samuelverburg-sys/PATS-MP16-DIY/hardware/mp16/PARTS.md

# PATS MP-16 DIY kit rev 2: parts

Generated from `mp16/design.py` by `tools/parts_table.py`; do not edit by hand.
Check every **unverified** LCSC number in the JLCPCB BOM preview (description, value, package) before ordering.

| Qty | References | Value | Footprint | LCSC | Part | Source of the LCSC number |
|---|---|---|---|---|---|---|
| 1 | SW1 | SHIFT | MX-Hotswap-1U | C41430893 | Kailh CPG151101S11-16 | rev-1 BOM |
| 17 | D1, D2, D3, D4, D5, D6, D7, D8, D9, D10, D11, D12, D13, D14, D15, D16, D17 | SK6812MINI-E | LED_SK6812MINI-E_3.2x2.8mm_P1.5mm_ReverseMount | C5149201 | SK6812MINI-E | Samuel (PATS BOM exports) |
| 20 | C1, C2, C3, C4, C5, C6, C7, C8, C9, C10, C11, C12, C13, C14, C15, C16, C17, C21, C22, C23 | 100n | C_0603_1608Metric | C14663 |  | PATS checked list |
| 1 | SW2 | P1 | MX-Hotswap-1U | C41430893 | Kailh CPG151101S11-16 | rev-1 BOM |
| 1 | SW3 | P2 | MX-Hotswap-1U | C41430893 | Kailh CPG151101S11-16 | rev-1 BOM |
| 1 | SW4 | P3 | MX-Hotswap-1U | C41430893 | Kailh CPG151101S11-16 | rev-1 BOM |
| 1 | SW5 | P4 | MX-Hotswap-1U | C41430893 | Kailh CPG151101S11-16 | rev-1 BOM |
| 1 | SW6 | P5 | MX-Hotswap-1U | C41430893 | Kailh CPG151101S11-16 | rev-1 BOM |
| 1 | SW7 | P6 | MX-Hotswap-1U | C41430893 | Kailh CPG151101S11-16 | rev-1 BOM |
| 1 | SW8 | P7 | MX-Hotswap-1U | C41430893 | Kailh CPG151101S11-16 | rev-1 BOM |
| 1 | SW9 | P8 | MX-Hotswap-1U | C41430893 | Kailh CPG151101S11-16 | rev-1 BOM |
| 1 | SW10 | P9 | MX-Hotswap-1U | C41430893 | Kailh CPG151101S11-16 | rev-1 BOM |
| 1 | SW11 | P10 | MX-Hotswap-1U | C41430893 | Kailh CPG151101S11-16 | rev-1 BOM |
| 1 | SW12 | P11 | MX-Hotswap-1U | C41430893 | Kailh CPG151101S11-16 | rev-1 BOM |
| 1 | SW13 | P12 | MX-Hotswap-1U | C41430893 | Kailh CPG151101S11-16 | rev-1 BOM |
| 1 | SW14 | P13 | MX-Hotswap-1U | C41430893 | Kailh CPG151101S11-16 | rev-1 BOM |
| 1 | SW15 | P14 | MX-Hotswap-1U | C41430893 | Kailh CPG151101S11-16 | rev-1 BOM |
| 1 | SW16 | P15 | MX-Hotswap-1U | C41430893 | Kailh CPG151101S11-16 | rev-1 BOM |
| 1 | SW17 | P16 | MX-Hotswap-1U | C41430893 | Kailh CPG151101S11-16 | rev-1 BOM |
| 1 | U4 | 74AHCT1G125 | SOT-23-5 | C52140417 | 74AHCT1G125GV | Samuel (PATS BOM exports) |
| 2 | R1, R42 | 33 | R_0402_1005Metric | C25105 |  | **unverified** |
| 12 | C18, C30, C31, C32, C33, C34, C35, C38, C39, C40, C53, C71 | 100n | C_0402_1005Metric | C1525 |  | **unverified** |
| 1 | ENC1 | PEC11R 24 PPR + switch | RotaryEncoder_Bourns_PEC11R-4215F-S0024 | C143790 | Bourns PEC11R-4215F-S0024 | rev-1 BOM |
| 5 | R2, R3, R11, R24, R31 | 10k | R_0402_1005Metric | C25744 |  | **unverified** |
| 2 | C19, C20 | 10n | C_0402_1005Metric | C15195 |  | **unverified** |
| 3 | U1, U2, U3 | 74HC165 | TSSOP-16_4.4x5mm_P0.65mm | C80696 | 74HC165PW | PATS checked list |
| 6 | RN1, RN2, RN3, RN4, RN5, RN6 | 4x10k | R_Array_Convex_4x0603 | C29718 | 4D03WGJ0103T5E | PATS checked list |
| 1 | J2 | OLED SSD1306 I2C | PinSocket_1x04_P2.54mm_Vertical | - |  | none: choose a part |
| 2 | R4, R5 | 4.7k | R_0402_1005Metric | C25900 |  | **unverified** |
| 1 | U10 | RP2040 | QFN-56-1EP_7x7mm_P0.4mm_EP3.2x3.2mm | C2040 | RP2040 | **unverified** |
| 4 | C36, C37, C50, C57 | 1u | C_0402_1005Metric | C52923 |  | **unverified** |
| 1 | U11 | W25Q128JV | SOIC-8_5.23x5.23mm_P1.27mm | C97521 | W25Q128JVSIQ | LCSC listing seen 2026-10-22 |
| 3 | R10, R12, R21 | 1k | R_0402_1005Metric | C11702 |  | **unverified** |
| 1 | SW18 | BOOT | SW_Push_1P1T_NO_CK_KMR2 | C72443 | C&K KMR221GLFS | PATS checked list |
| 1 | SW19 | RESET | SW_Push_1P1T_NO_CK_KMR2 | C72443 | C&K KMR221GLFS | PATS checked list |
| 1 | Y1 | 12MHz | Crystal_SMD_3225-4Pin_3.2x2.5mm | C20625731 | Abracon ABM8-272-T3 | LCSC listing seen 2026-10-22 |
| 2 | C41, C42 | 15p | C_0402_1005Metric | C1548 |  | **unverified** |
| 1 | J3 | USB-C | USB_C_Receptacle_HRO_TYPE-C-31-M-12 | C165948 | HRO TYPE-C-31-M-12 | PATS checked list |
| 2 | R13, R14 | 5.1k | R_0402_1005Metric | C25905 |  | **unverified** |
| 1 | F1 | 1.5A hold | Fuse_1206_3216Metric | - | 1206 PTC, 1.5 A hold, 6 V | none: choose a part |
| 2 | U12, U20 | USBLC6-2SC6 | SOT-23-6 | C2687116 | USBLC6-2SC6 | Samuel (PATS BOM exports) |
| 2 | R15, R16 | 27 | R_0402_1005Metric | C25100 |  | **unverified** |
| 1 | U13 | BQ24074 | VQFN-16-1EP_3x3mm_P0.5mm_EP1.6x1.6mm | C2861252 | BQ24074RGTR | Samuel (PATS BOM exports) |
| 5 | C51, C52, C55, C56, C58 | 10u | C_0603_1608Metric | C85713 | CL10A106MP8NNNC | rev-1 BOM |
| 1 | R20 | 3k | R_0402_1005Metric | - |  | none: choose a part |
| 1 | R22 | 180 | R_0402_1005Metric | - |  | none: choose a part |
| 1 | R23 | 4.12k | R_0603_1608Metric | C2960702 |  | Samuel (PATS BOM exports) |
| 1 | D20 | charge | LED_SideView_XL-1606_RD | C965860 | XINGLIGHT XL-1606SURC | rev-1 BOM |
| 1 | R25 | 1.5k | R_0402_1005Metric | C25867 |  | **unverified** |
| 1 | J7 | LiPo 1S (pin 1 = GND, pin 2 = +) | JST_PH_S2B-PH-K-S_Horizontal | C173752 | JST S2B-PH-K-S(LF)(SN) | rev-1 BOM |
| 1 | Q1 | DMG2305UX | SOT-23 | C150470 | DMG2305UX-7 | LCSC listing seen 2026-10-22 |
| 3 | R26, R27, R29 | 100k | R_0402_1005Metric | C25741 |  | **unverified** |
| 1 | Q2 | MMBT3906 | SOT-23 | C2940 | MMBT3906 | **unverified** |
| 2 | R44, R45 | 1M | R_0402_1005Metric | C26083 |  | **unverified** |
| 1 | SW20 | Power | SW_SPDT_MK-12C02-G015 | C2911519 | G-Switch MK-12C02-G015 | rev-1 BOM |
| 1 | U16 | TPS22917 | SOT-23-6 | C2681320 | TPS22917DBVR | PATS checked list |
| 1 | C54 | 1n | C_0402_1005Metric | C1523 |  | **unverified** |
| 1 | U17 | AP2112K-3.3 | SOT-23-5 | C51118 | AP2112K-3.3TRG1 | PATS checked list |
| 1 | U18 | MT3608 | SOT-23-6 | C84817 | MT3608 | PATS checked list |
| 4 | C24, C60, C61, C62 | 22u | C_0805_2012Metric | C45783 |  | PATS checked list |
| 1 | L1 | 10uH | L_Coilcraft_XAL4040-XXX | C5144883 | XAL4040-103MEC | PATS checked list |
| 1 | D21 | SS34 | D_SMA | C8678 | SS34 | PATS checked list |
| 1 | R30 | 75k | R_0402_1005Metric | - |  | none: choose a part |
| 1 | J4 | MIDI IN | Jack_3.5mm_PJ-320-3P-SMT | C17701688 | PJ-320-3P SMT | rev-1 BOM |
| 1 | C70 | 100p | C_0402_1005Metric | C1546 |  | **unverified** |
| 1 | R40 | 220 | R_0402_1005Metric | C25091 |  | **unverified** |
| 1 | D22 | 1N4148W | D_SOD-123 | C81598 | 1N4148W | **unverified** |
| 1 | U19 | TLP109 | Toshiba_SO6-5P_TLP109 | C406798 | TLP109(TPL,E | rev-1 BOM |
| 1 | R41 | 2.2k | R_0402_1005Metric | C25879 |  | **unverified** |
| 1 | J5 | MIDI OUT | Jack_3.5mm_PJ-320-3P-SMT | C17701688 | PJ-320-3P SMT | rev-1 BOM |
| 1 | R43 | 10 | R_0402_1005Metric | C25077 |  | **unverified** |
| 1 | J6 | I2C (Qwiic) | JST_SH_SM04B-SRSS-TB_1x04-1MP_P1.00mm_Horizontal | C160404 | JST SM04B-SRSS-TB(LF)(SN) | **unverified** |
