samuelverburg-sys/PATS-MP16-DIY/hardware/mp16/fab/mp16-bom.csv

Comment | Designator | Footprint | LCSC Part # | Manufacturer Part
100n | C1,C2,C3,C4,C5,C6,C7,C8,C9,C10,C11,C12,C13,C14,C15,C16,C17,C21,C22,C23 | C_0603_1608Metric | C14663
100n | C18,C30,C31,C32,C33,C34,C35,C38,C39,C40,C53,C71 | C_0402_1005Metric | C1525
10n | C19,C20 | C_0402_1005Metric | C15195
22u | C24,C60,C61,C62 | C_0805_2012Metric | C45783
1u | C36,C37,C50,C57 | C_0402_1005Metric | C52923
15p | C41,C42 | C_0402_1005Metric | C1548
CL10A106MP8NNNC | C51,C52,C55,C56,C58 | C_0603_1608Metric | C85713 | CL10A106MP8NNNC
1n | C54 | C_0402_1005Metric | C1523
100p | C70 | C_0402_1005Metric | C1546
SK6812MINI-E | D1,D2,D3,D4,D5,D6,D7,D8,D9,D10,D11,D12,D13,D14,D15,D16,D17 | LED_SK6812MINI-E_3.2x2.8mm_P1.5mm_ReverseMount | C5149201 | SK6812MINI-E
XINGLIGHT XL-1606SURC | D20 | LED_SideView_XL-1606_RD | C965860 | XINGLIGHT XL-1606SURC
SS34 | D21 | D_SMA | C8678 | SS34
1N4148W | D22 | D_SOD-123 | C81598 | 1N4148W
1.5A hold | F1 | Fuse_1206_3216Metric |  | 1206 PTC, 1.5 A hold, 6 V
HRO TYPE-C-31-M-12 | J3 | USB_C_Receptacle_HRO_TYPE-C-31-M-12 | C165948 | HRO TYPE-C-31-M-12
PJ-320-3P SMT | J4,J5 | Jack_3.5mm_PJ-320-3P-SMT | C17701688 | PJ-320-3P SMT
JST SM04B-SRSS-TB(LF)(SN) | J6 | JST_SH_SM04B-SRSS-TB_1x04-1MP_P1.00mm_Horizontal | C160404 | JST SM04B-SRSS-TB(LF)(SN)
XAL4040-103MEC | L1 | L_Coilcraft_XAL4040-XXX | C5144883 | XAL4040-103MEC
DMG2305UX-7 | Q1 | SOT-23 | C150470 | DMG2305UX-7
MMBT3906 | Q2 | SOT-23 | C2940 | MMBT3906
33 | R1,R42 | R_0402_1005Metric | C25105
10k | R2,R3,R11,R24,R31 | R_0402_1005Metric | C25744
4.7k | R4,R5 | R_0402_1005Metric | C25900
1k | R10,R12,R21 | R_0402_1005Metric | C11702
5.1k | R13,R14 | R_0402_1005Metric | C25905
27 | R15,R16 | R_0402_1005Metric | C25100
3k | R20 | R_0402_1005Metric
180 | R22 | R_0402_1005Metric
4.12k | R23 | R_0603_1608Metric | C2960702
1.5k | R25 | R_0402_1005Metric | C25867
100k | R26,R27,R29 | R_0402_1005Metric | C25741
75k | R30 | R_0402_1005Metric
220 | R40 | R_0402_1005Metric | C25091
2.2k | R41 | R_0402_1005Metric | C25879
10 | R43 | R_0402_1005Metric | C25077
1M | R44,R45 | R_0402_1005Metric | C26083
4D03WGJ0103T5E | RN1,RN2,RN3,RN4,RN5,RN6 | R_Array_Convex_4x0603 | C29718 | 4D03WGJ0103T5E
Kailh CPG151101S11-16 | SW1,SW2,SW3,SW4,SW5,SW6,SW7,SW8,SW9,SW10,SW11,SW12,SW13,SW14,SW15,SW16,SW17 | MX-Hotswap-1U | C41430893 | Kailh CPG151101S11-16
C&K KMR221GLFS | SW18,SW19 | SW_Push_1P1T_NO_CK_KMR2 | C72443 | C&K KMR221GLFS
G-Switch MK-12C02-G015 | SW20 | SW_SPDT_MK-12C02-G015 | C2911519 | G-Switch MK-12C02-G015
74HC165PW | U1,U2,U3 | TSSOP-16_4.4x5mm_P0.65mm | C80696 | 74HC165PW
74AHCT1G125GV | U4 | SOT-23-5 | C52140417 | 74AHCT1G125GV
RP2040 | U10 | QFN-56-1EP_7x7mm_P0.4mm_EP3.2x3.2mm | C2040 | RP2040
W25Q128JVSIQ | U11 | SOIC-8_5.23x5.23mm_P1.27mm | C97521 | W25Q128JVSIQ
USBLC6-2SC6 | U12,U20 | SOT-23-6 | C2687116 | USBLC6-2SC6
BQ24074RGTR | U13 | VQFN-16-1EP_3x3mm_P0.5mm_EP1.6x1.6mm | C2861252 | BQ24074RGTR
TPS22917DBVR | U16 | SOT-23-6 | C2681320 | TPS22917DBVR
AP2112K-3.3TRG1 | U17 | SOT-23-5 | C51118 | AP2112K-3.3TRG1
MT3608 | U18 | SOT-23-6 | C84817 | MT3608
TLP109(TPL,E | U19 | Toshiba_SO6-5P_TLP109 | C406798 | TLP109(TPL,E
Abracon ABM8-272-T3 | Y1 | Crystal_SMD_3225-4Pin_3.2x2.5mm | C20625731 | Abracon ABM8-272-T3
