samuelverburg-sys/PATS-MP16-DIY/enclosure/stl/Midplate.stl

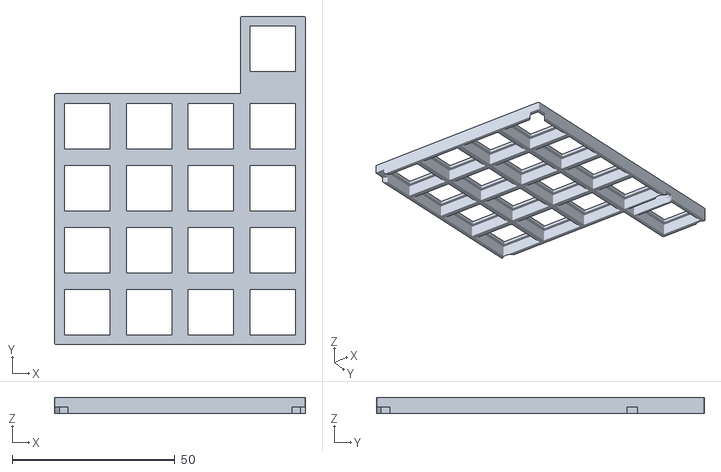
[picture p2: CAD file, 2026-10-22]
enclosure/stl/Midplate.stl
77.2 x 101.0 x 5.00
