samuelverburg-sys/PATS-MP16-DIY/enclosure/stl/Switch.stl

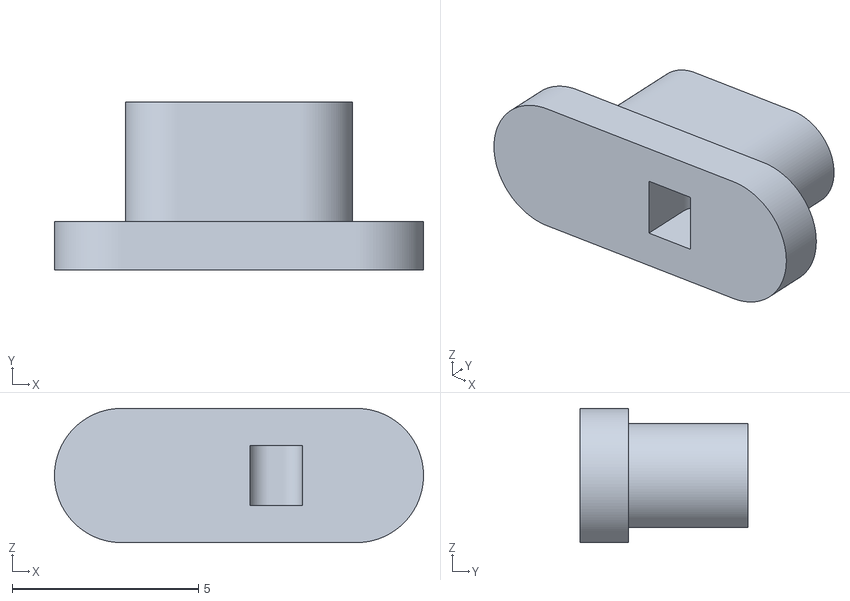
[picture p3: CAD file, 2026-10-22]
enclosure/stl/Switch.stl
9.90 x 4.50 x 3.60
