samuelverburg-sys/PATS-MP16-DIY/enclosure/stl/Top.stl

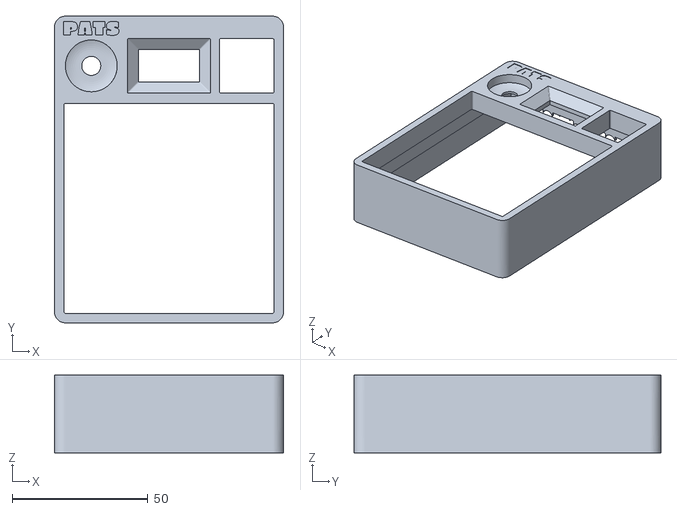
[picture p4: CAD file, 2026-10-22]
enclosure/stl/Top.stl
84.2 x 112.8 x 28.6
