samuelverburg-sys/PATS-MP16-DIY/enclosure/stl/OLED standoff.stl

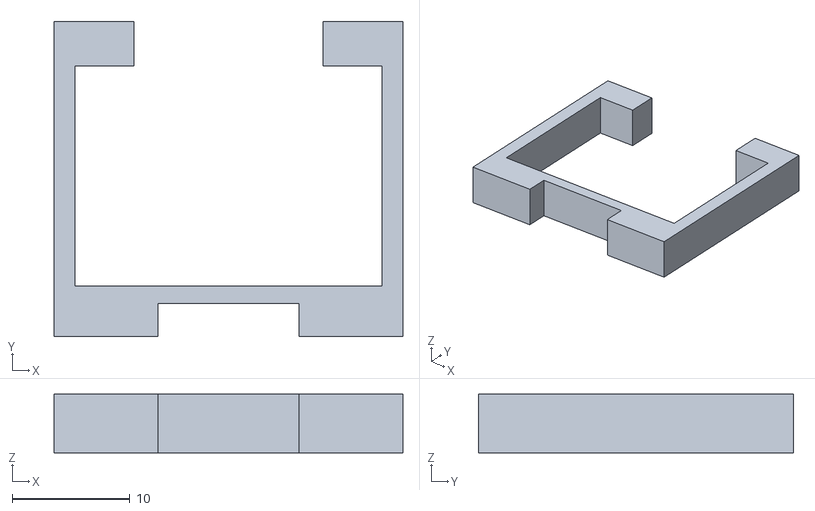
[picture p6: CAD file, 2026-10-22]
enclosure/stl/OLED standoff.stl
29.6 x 26.8 x 5.00
