samuelverburg-sys/PATS-MP16-DIY/enclosure/stl/Bottom.stl

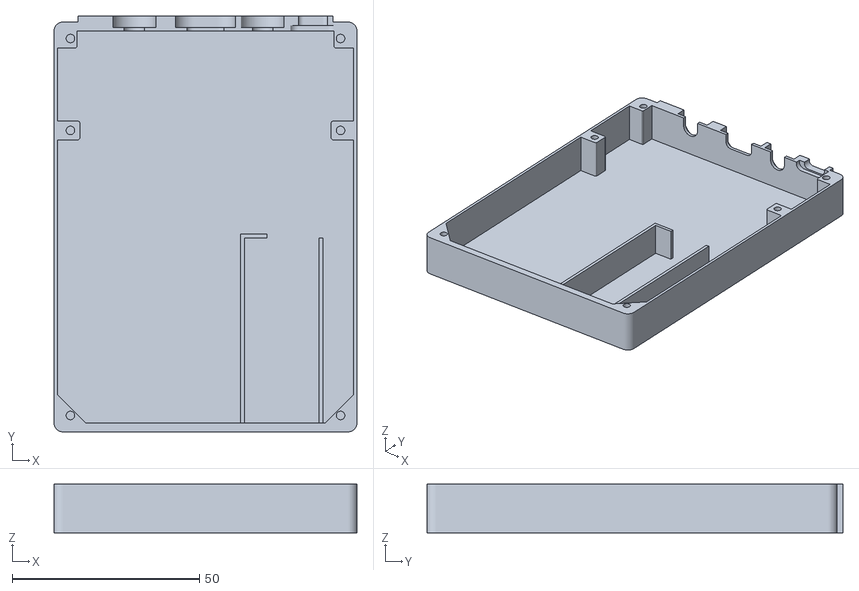
[picture p7: CAD file, 2026-10-22]
enclosure/stl/Bottom.stl
81.0 x 111.2 x 13.0
