samuelverburg-sys/PATS-MP16-DIY/(list of files, drawings)

Other design files:
hardware/reference/rev1-pcb.easyeda.json
hardware/reference/rev1-schematic.easyeda.json
