samuelverburg-sys/PATS-MP16-DIY/hardware/mp16/mp16.kicad_pcb

## KiCad design hardware/mp16/mp16.kicad_pcb (2026-11-05)

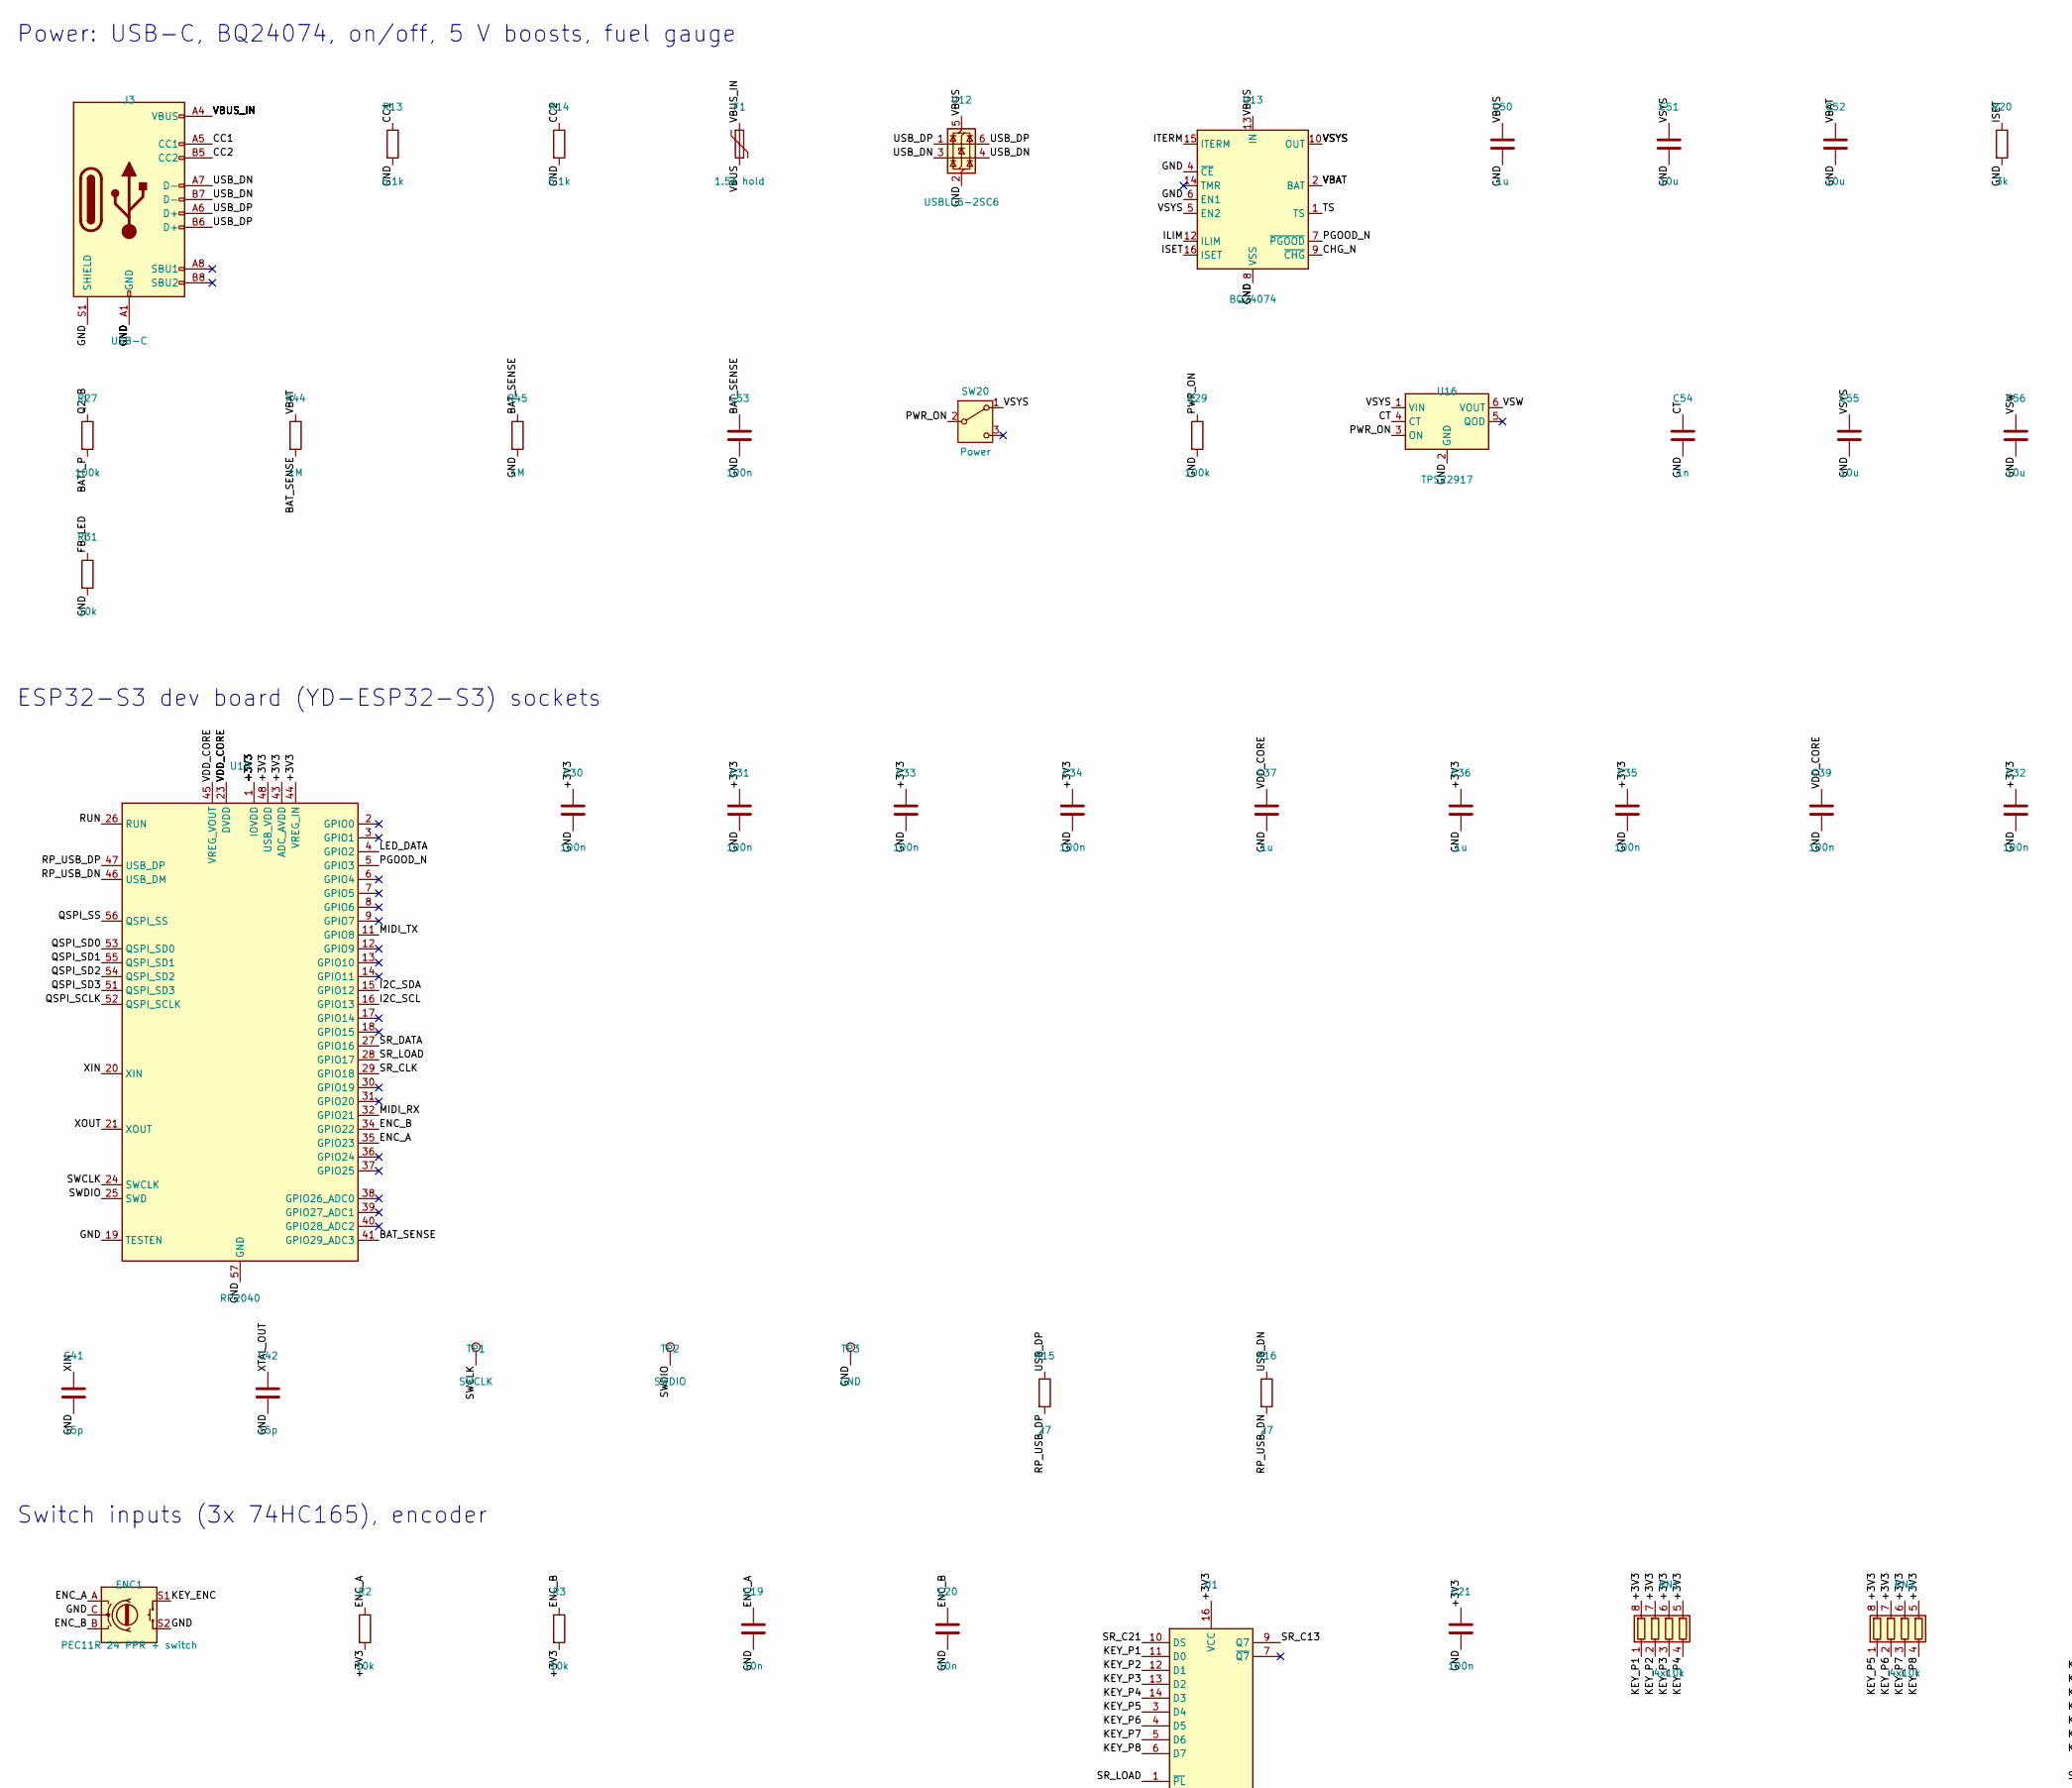
[picture p8: schematic mp16.kicad_sch, PATS MP-16 DIY kit rev 2, part in row 1, column 1]

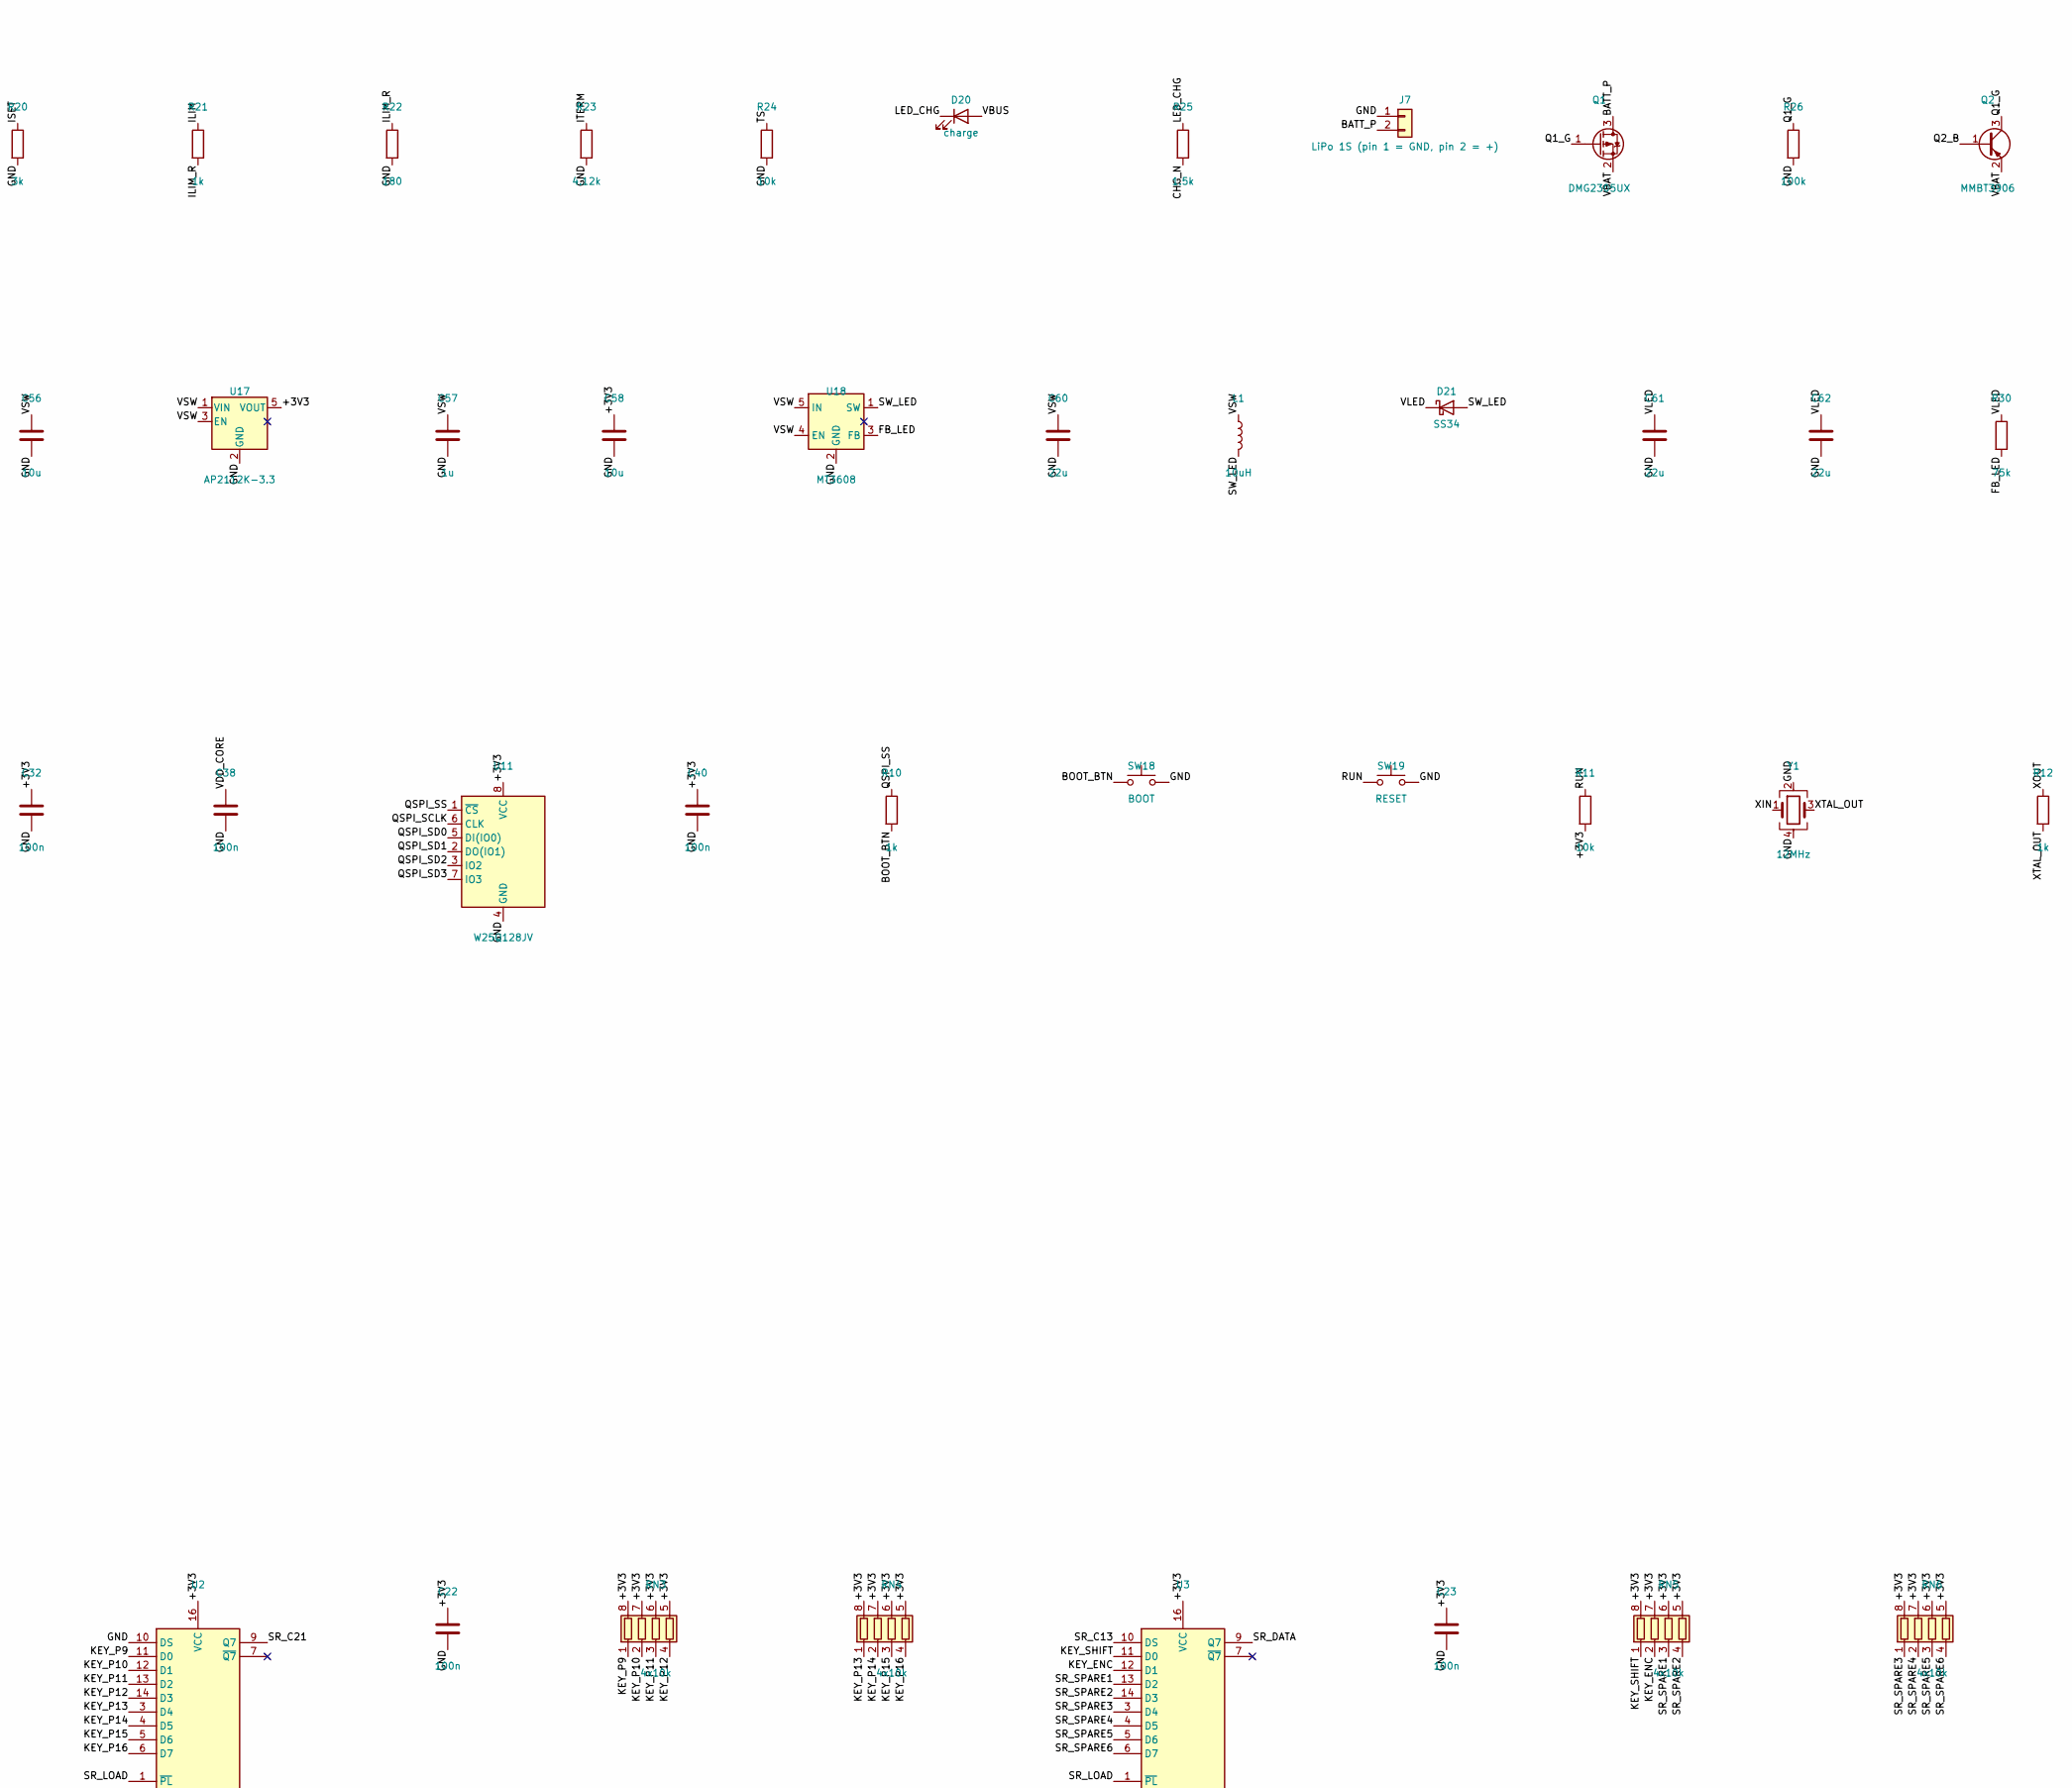
[picture p9: schematic mp16.kicad_sch, PATS MP-16 DIY kit rev 2, part in row 1, column 2]

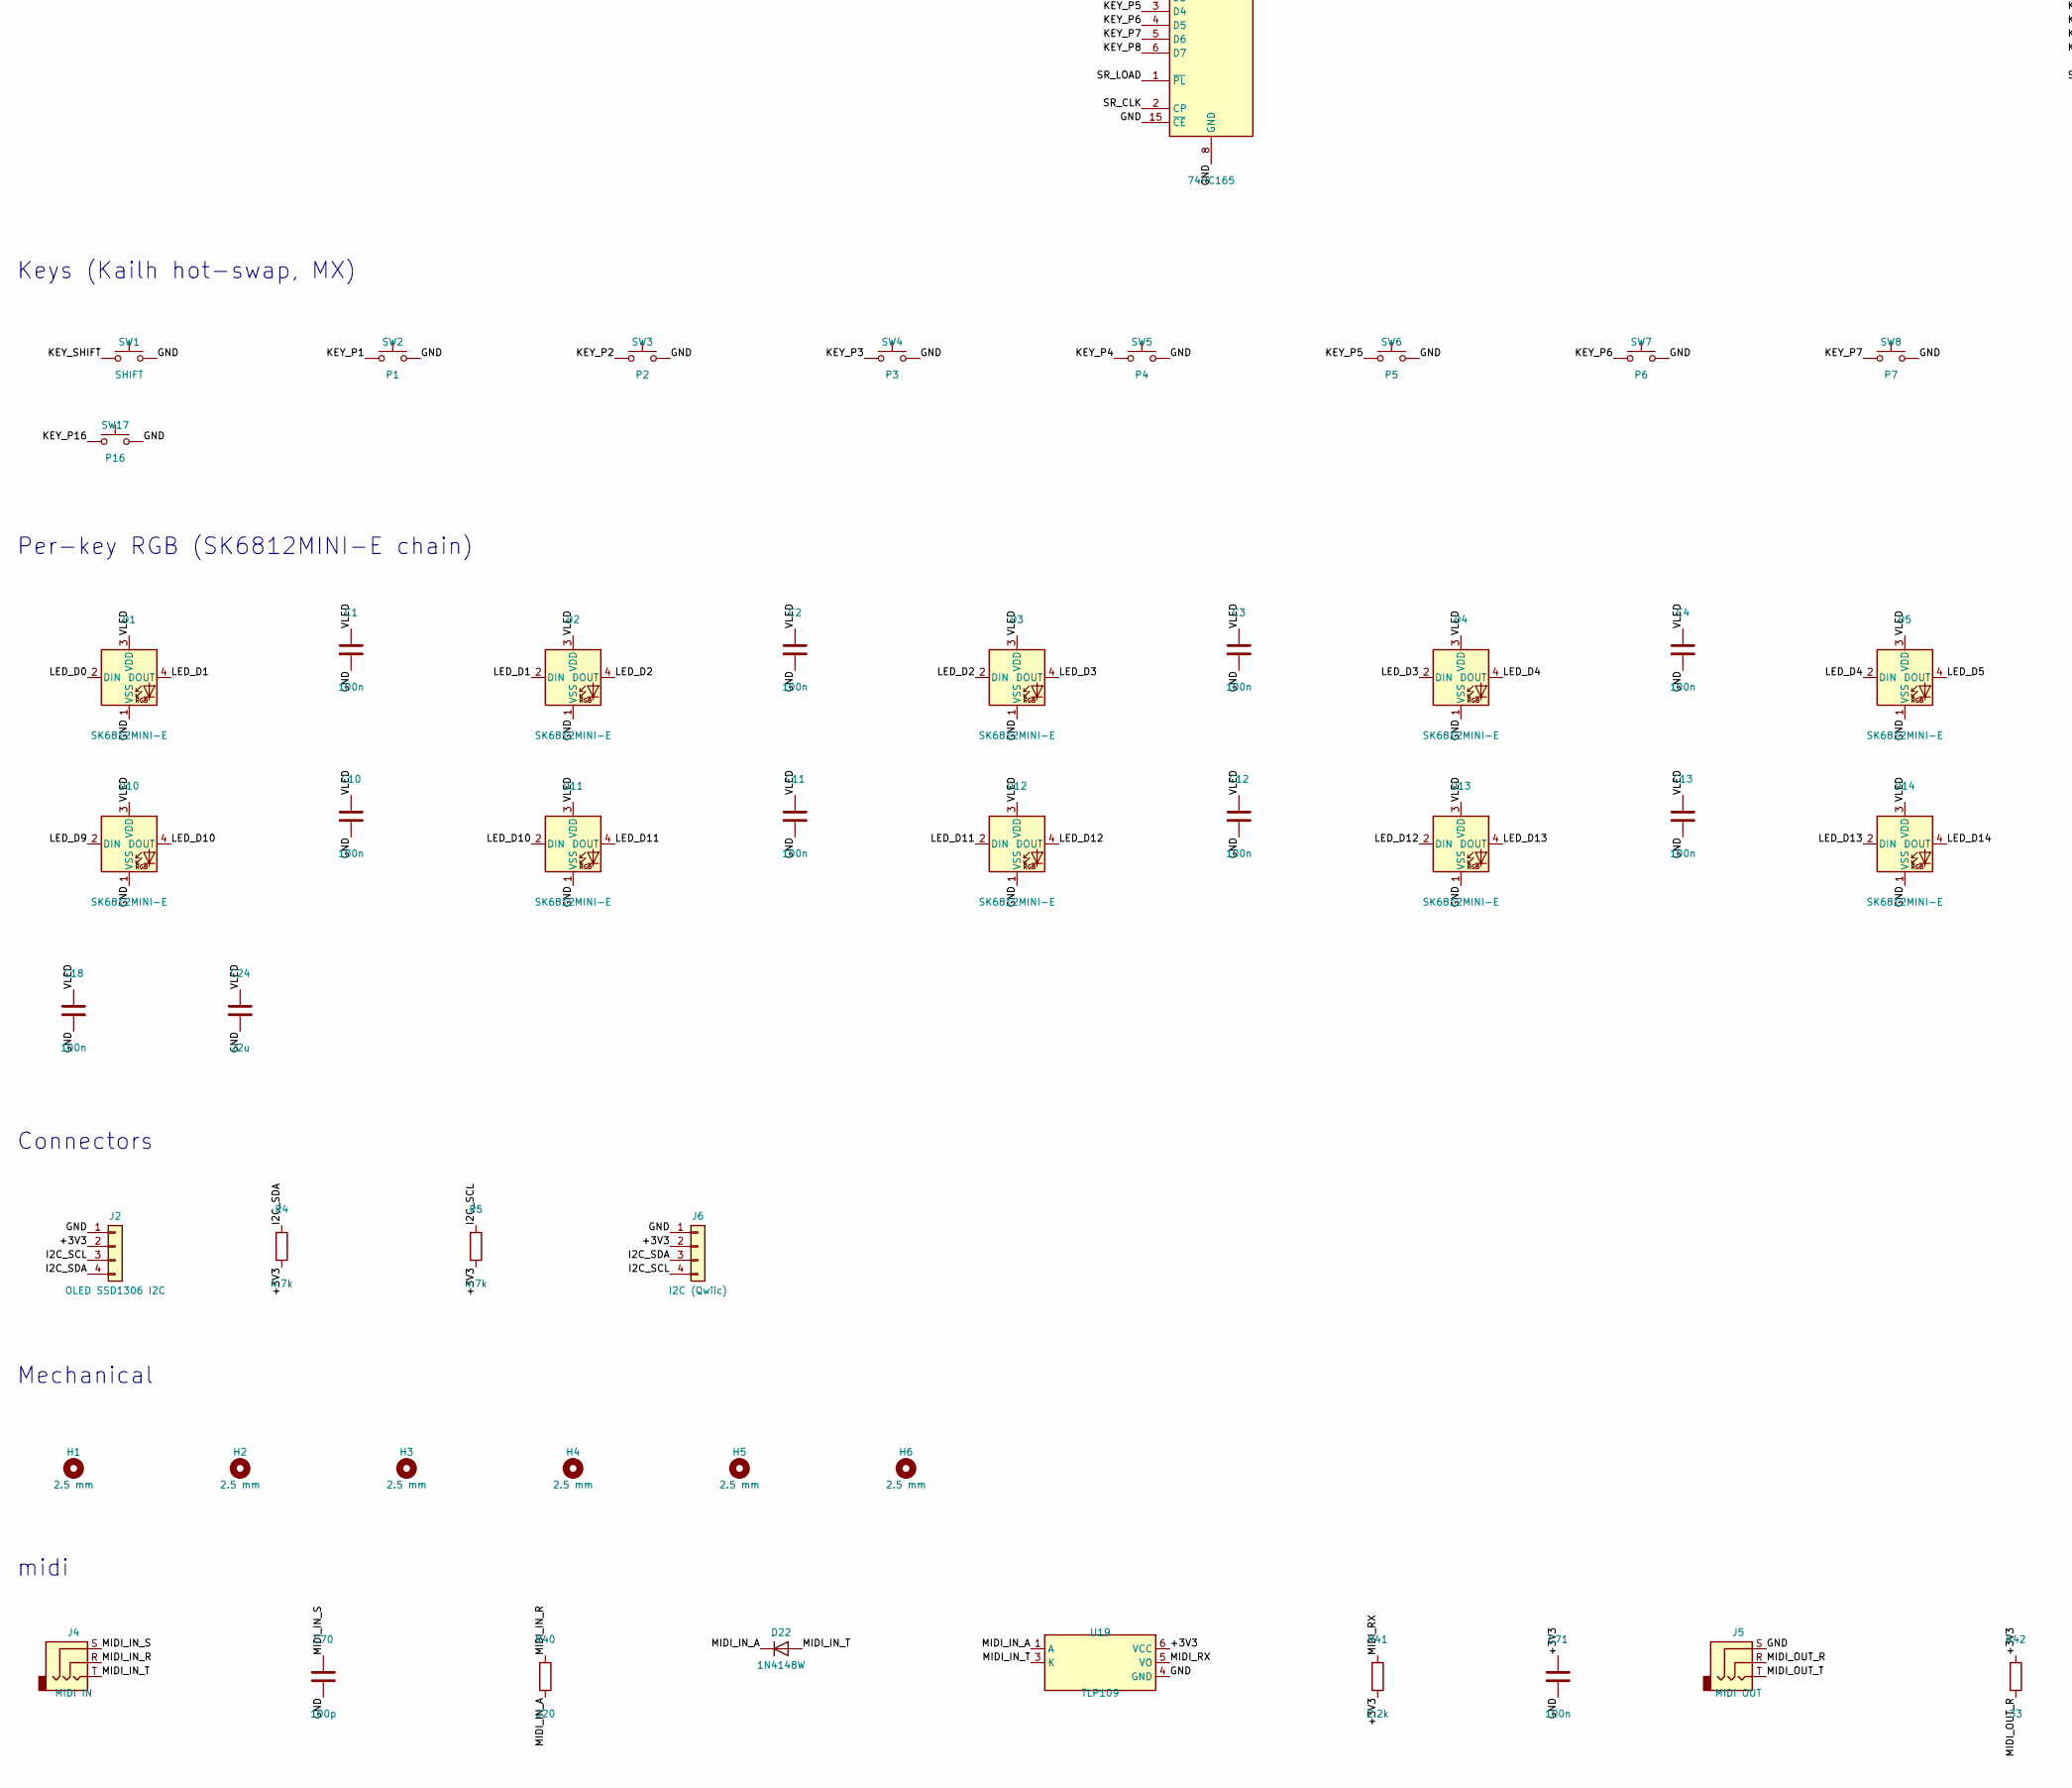
[picture p10: schematic mp16.kicad_sch, PATS MP-16 DIY kit rev 2, part in row 2, column 1]

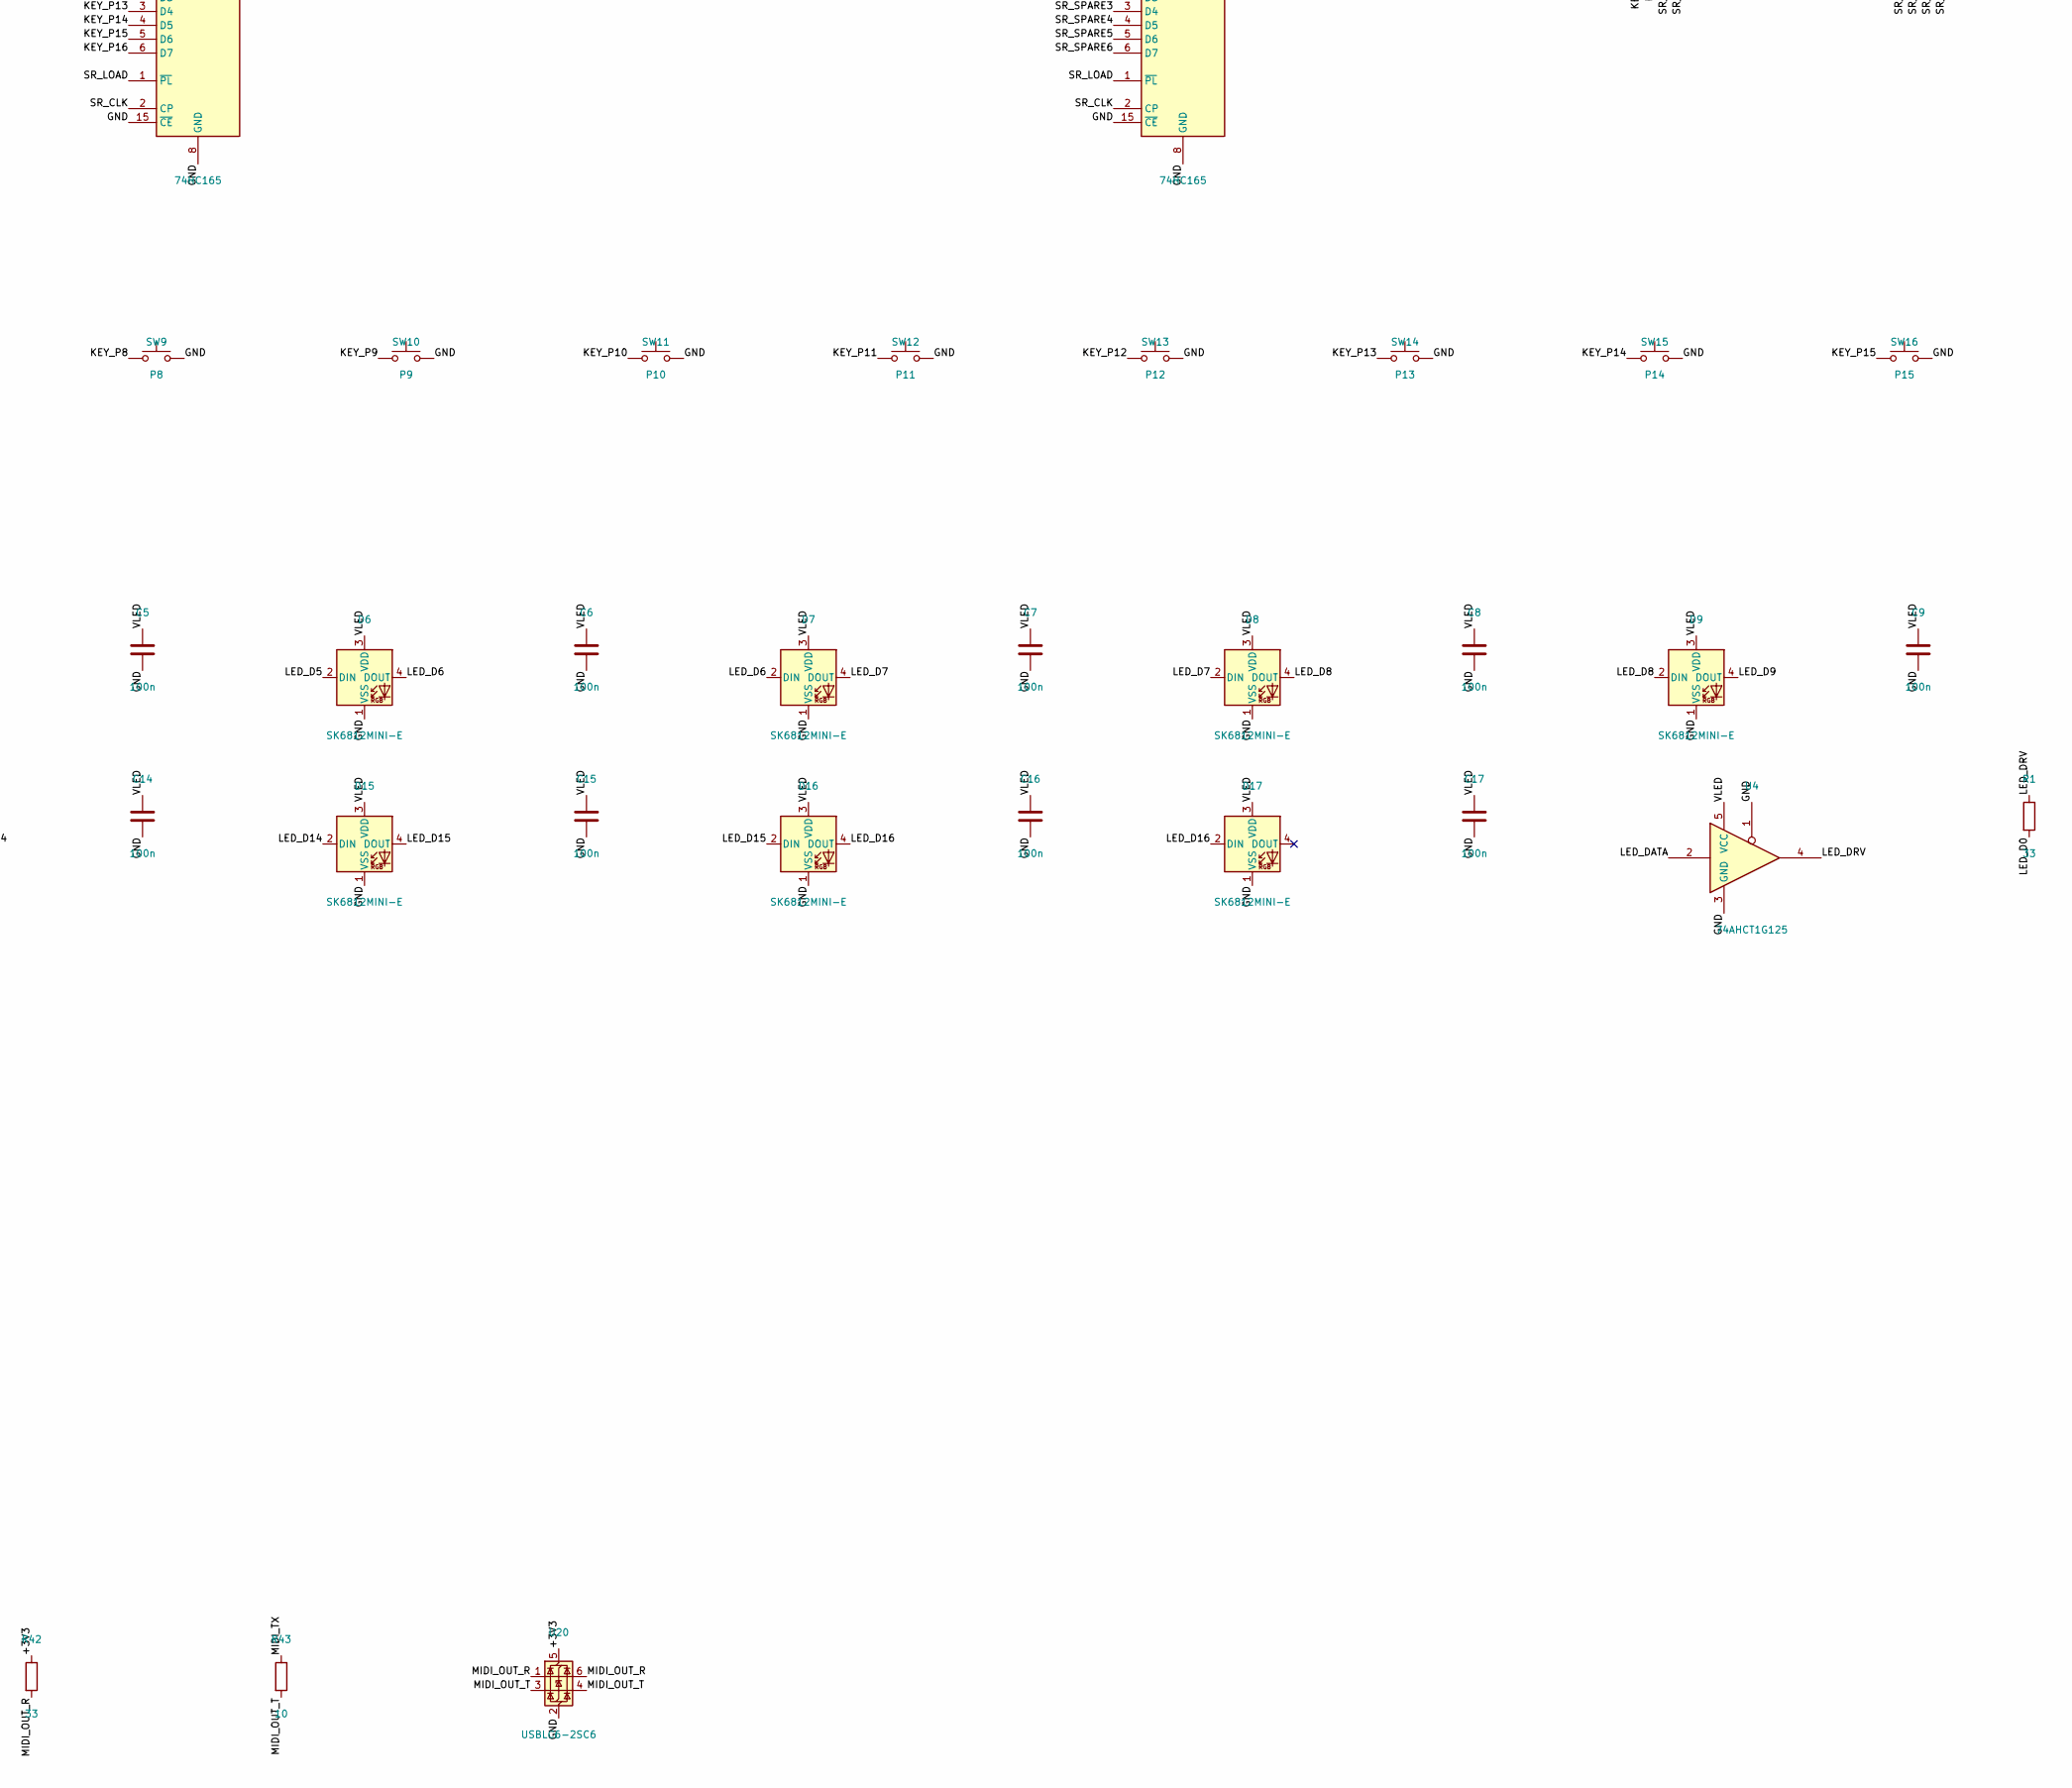
[picture p11: schematic mp16.kicad_sch, PATS MP-16 DIY kit rev 2, part in row 2, column 2]

Parts:
C1, C2, C3, C4, C5, C6, C7, C8, C9, C10, C11, C12, C13, C14, C15, C16, C17, C21, C22, C23: 100n; C_0603_1608Metric
C18, C30, C31, C32, C33, C34, C35, C38, C39, C40, C53, C71: 100n; C_0402_1005Metric
C19, C20: 10n; C_0402_1005Metric
C24, C60, C61, C62: 22u; C_0805_2012Metric
C36, C37, C50, C57: 1u; C_0402_1005Metric
C41, C42: 15p; C_0402_1005Metric
C51, C52, C55, C56, C58: 10u; C_0603_1608Metric; MPN CL10A106MP8NNNC
C54: 1n; C_0402_1005Metric
C70: 100p; C_0402_1005Metric
D1, D2, D3, D4, D5, D6, D7, D8, D9, D10, D11, D12, D13, D14, D15, D16, D17: SK6812MINI-E; LED_SK6812MINI-E_3.2x2.8mm_P1.5mm_ReverseMount; MPN SK6812MINI-E
D20: charge; LED_SideView_XL-1606_RD; MPN XINGLIGHT XL-1606SURC
D21: SS34; D_SMA; MPN SS34
D22: 1N4148W; D_SOD-123; MPN 1N4148W
ENC1: PEC11R 24 PPR + switch; RotaryEncoder_Bourns_PEC11R-4215F-S0024; MPN Bourns PEC11R-4215F-S0024
F1: 1.5A hold; Fuse_1206_3216Metric; MPN 1206 PTC, 1.5 A hold, 6 V
H1, H2, H3, H4, H5, H6: 2.5 mm; MountingHole_2.5mm
J2: OLED SSD1306 I2C; PinSocket_1x04_P2.54mm_Vertical
J3: USB-C; USB_C_Receptacle_HRO_TYPE-C-31-M-12; MPN HRO TYPE-C-31-M-12
J4: MIDI IN; Jack_3.5mm_PJ-320-3P-SMT; MPN PJ-320-3P SMT
J5: MIDI OUT; Jack_3.5mm_PJ-320-3P-SMT; MPN PJ-320-3P SMT
J6: I2C (Qwiic); JST_SH_SM04B-SRSS-TB_1x04-1MP_P1.00mm_Horizontal; MPN JST SM04B-SRSS-TB(LF)(SN)
J7: LiPo 1S (pin 1 = GND, pin 2 = +); JST_PH_S2B-PH-K-S_Horizontal; MPN JST S2B-PH-K-S(LF)(SN)
L1: 10uH; L_Coilcraft_XAL4040-XXX; MPN XAL4040-103MEC
Q1: DMG2305UX; SOT-23; MPN DMG2305UX-7
Q2: MMBT3906; SOT-23; MPN MMBT3906
R1, R42: 33; R_0402_1005Metric
R2, R3, R11, R24, R31: 10k; R_0402_1005Metric
R4, R5: 4.7k; R_0402_1005Metric
R10, R12, R21: 1k; R_0402_1005Metric
R13, R14: 5.1k; R_0402_1005Metric
R15, R16: 27; R_0402_1005Metric
R20: 3k; R_0402_1005Metric
R22: 180; R_0402_1005Metric
R23: 4.12k; R_0603_1608Metric
R25: 1.5k; R_0402_1005Metric
R26, R27, R29: 100k; R_0402_1005Metric
R30: 75k; R_0402_1005Metric
R40: 220; R_0402_1005Metric
R41: 2.2k; R_0402_1005Metric
R43: 10; R_0402_1005Metric
R44, R45: 1M; R_0402_1005Metric
RN1, RN2, RN3, RN4, RN5, RN6: 4x10k; R_Array_Convex_4x0603; MPN 4D03WGJ0103T5E
SW1: SHIFT; MX-Hotswap-1U; MPN Kailh CPG151101S11-16
SW2: P1; MX-Hotswap-1U; MPN Kailh CPG151101S11-16
SW3: P2; MX-Hotswap-1U; MPN Kailh CPG151101S11-16
SW4: P3; MX-Hotswap-1U; MPN Kailh CPG151101S11-16
SW5: P4; MX-Hotswap-1U; MPN Kailh CPG151101S11-16
SW6: P5; MX-Hotswap-1U; MPN Kailh CPG151101S11-16
SW7: P6; MX-Hotswap-1U; MPN Kailh CPG151101S11-16
SW8: P7; MX-Hotswap-1U; MPN Kailh CPG151101S11-16
SW9: P8; MX-Hotswap-1U; MPN Kailh CPG151101S11-16
SW10: P9; MX-Hotswap-1U; MPN Kailh CPG151101S11-16
SW11: P10; MX-Hotswap-1U; MPN Kailh CPG151101S11-16
SW12: P11; MX-Hotswap-1U; MPN Kailh CPG151101S11-16
SW13: P12; MX-Hotswap-1U; MPN Kailh CPG151101S11-16
SW14: P13; MX-Hotswap-1U; MPN Kailh CPG151101S11-16
SW15: P14; MX-Hotswap-1U; MPN Kailh CPG151101S11-16
SW16: P15; MX-Hotswap-1U; MPN Kailh CPG151101S11-16
SW17: P16; MX-Hotswap-1U; MPN Kailh CPG151101S11-16
SW18: BOOT; SW_Push_1P1T_NO_CK_KMR2; MPN C&K KMR221GLFS
SW19: RESET; SW_Push_1P1T_NO_CK_KMR2; MPN C&K KMR221GLFS
SW20: Power; SW_SPDT_MK-12C02-G015; MPN G-Switch MK-12C02-G015
TP1: SWCLK; TestPoint_Pad_D1.0mm
TP2: SWDIO; TestPoint_Pad_D1.0mm
TP3: GND; TestPoint_Pad_D1.0mm
U1, U2, U3: 74HC165; TSSOP-16_4.4x5mm_P0.65mm; MPN 74HC165PW
U4: 74AHCT1G125; SOT-23-5; MPN 74AHCT1G125GV
U10: RP2040; QFN-56-1EP_7x7mm_P0.4mm_EP3.2x3.2mm; MPN RP2040
U11: W25Q128JV; SOIC-8_5.23x5.23mm_P1.27mm; MPN W25Q128JVSIQ
U12, U20: USBLC6-2SC6; SOT-23-6; MPN USBLC6-2SC6
U13: BQ24074; VQFN-16-1EP_3x3mm_P0.5mm_EP1.6x1.6mm; MPN BQ24074RGTR
U16: TPS22917; SOT-23-6; MPN TPS22917DBVR
U17: AP2112K-3.3; SOT-23-5; MPN AP2112K-3.3TRG1
U18: MT3608; SOT-23-6; MPN MT3608
U19: TLP109; Toshiba_SO6-5P_TLP109; MPN TLP109(TPL,E
Y1: 12MHz; Crystal_SMD_3225-4Pin_3.2x2.5mm; MPN Abracon ABM8-272-T3

Connections:
+3V3: C21.1, C22.1, C23.1, C30.1, C31.1, C32.1, C33.1, C34.1, C35.1, C36.1, C40.1, C58.1, C71.1, J2.2, J6.2, R2.2, R3.2, R4.2, R5.2, R11.2, R41.2, R42.1, RN1.5 (R4.2), RN1.6 (R3.2), RN1.7 (R2.2), RN1.8 (R1.2), RN2.5 (R4.2), RN2.6 (R3.2), RN2.7 (R2.2), RN2.8 (R1.2), RN3.5 (R4.2), RN3.6 (R3.2), RN3.7 (R2.2), RN3.8 (R1.2), RN4.5 (R4.2), RN4.6 (R3.2), RN4.7 (R2.2), RN4.8 (R1.2), RN5.5 (R4.2), RN5.6 (R3.2), RN5.7 (R2.2), RN5.8 (R1.2), RN6.5 (R4.2), RN6.6 (R3.2), RN6.7 (R2.2), RN6.8 (R1.2), U1.16 (VCC), U2.16 (VCC), U3.16 (VCC), U10.1 (IOVDD), U10.10 (IOVDD), U10.22 (IOVDD), U10.33 (IOVDD), U10.42 (IOVDD), U10.43 (ADC_AVDD), U10.44 (VREG_IN), U10.48 (USB_VDD), U10.49 (IOVDD), U11.8 (VCC), U17.5 (VOUT), U19.6 (VCC), U20.5 (VBUS)
BATT_P: J7.2, Q1.3 (D), R27.2
BAT_SENSE: C53.1, R44.2, R45.1, U10.41 (GPIO29_ADC3)
BOOT_BTN: R10.2, SW18.1
CC1: J3.A5 (CC1), R13.1
CC2: J3.B5 (CC2), R14.1
CHG_N: R25.2, U13.9 (~CHG)
CT: C54.1, U16.4 (CT)
ENC_A: C19.1, ENC1.A, R2.1, U10.35 (GPIO23)
ENC_B: C20.1, ENC1.B, R3.1, U10.34 (GPIO22)
FB_LED: R30.2, R31.1, U18.3 (FB)
GND: C1.2, C2.2, C3.2, C4.2, C5.2, C6.2, C7.2, C8.2, C9.2, C10.2, C11.2, C12.2, C13.2, C14.2, C15.2, C16.2, C17.2, C18.2, C19.2, C20.2, C21.2, C22.2, C23.2, C24.2, C30.2, C31.2, C32.2, C33.2, C34.2, C35.2, C36.2, C37.2, C38.2, C39.2, C40.2, C41.2, C42.2, C50.2, C51.2, C52.2, C53.2, C54.2, C55.2, C56.2, C57.2, C58.2, C60.2, C61.2, C62.2, C70.2, C71.2, D1.1 (VSS), D2.1 (VSS), D3.1 (VSS), D4.1 (VSS), D5.1 (VSS), D6.1 (VSS), D7.1 (VSS), D8.1 (VSS), D9.1 (VSS), D10.1 (VSS), D11.1 (VSS), D12.1 (VSS), D13.1 (VSS), D14.1 (VSS), D15.1 (VSS), D16.1 (VSS), D17.1 (VSS), ENC1.C, ENC1.MP, ENC1.S2, J2.1, J3.A1 (GND), J3.A12 (GND), J3.B1 (GND), J3.B12 (GND), J3.S1 (SHIELD), J5.S, J6.1, J6.MP, J7.1, R13.2, R14.2, R20.2, R22.2, R23.2, R24.2, R26.2, R29.2, R31.2, R45.2, SW1.2, SW2.2, SW3.2, SW4.2, SW5.2, SW6.2, SW7.2, SW8.2, SW9.2, SW10.2, SW11.2, SW12.2, SW13.2, SW14.2, SW15.2, SW16.2, SW17.2, SW18.2, SW19.2, SW20.SH, TP3.1, U1.8 (GND), U1.15 (~CE), U2.8 (GND), U2.10 (DS), U2.15 (~CE), U3.8 (GND), U3.15 (~CE), U4.1, U4.3 (GND), U10.19 (TESTEN), U10.57 (GND), U11.4 (GND), U12.2 (GND), U13.4 (~CE), U13.6 (EN1), U13.8 (VSS), U13.17 (VSS), U16.2 (GND), U17.2 (GND), U18.2 (GND), U19.4 (GND), U20.2 (GND), Y1.2, Y1.4
I2C_SCL: J2.3, J6.4, R5.1, U10.16 (GPIO13)
I2C_SDA: J2.4, J6.3, R4.1, U10.15 (GPIO12)
ILIM: R21.1, U13.12 (ILIM)
ILIM_R: R21.2, R22.1
ISET: R20.1, U13.16 (ISET)
ITERM: R23.1, U13.15 (ITERM)
KEY_ENC: ENC1.S1, RN5.2 (R2.1), U3.12 (D1)
KEY_P1: RN1.1 (R1.1), SW2.1, U1.11 (D0)
KEY_P2: RN1.2 (R2.1), SW3.1, U1.12 (D1)
KEY_P3: RN1.3 (R3.1), SW4.1, U1.13 (D2)
KEY_P4: RN1.4 (R4.1), SW5.1, U1.14 (D3)
KEY_P5: RN2.1 (R1.1), SW6.1, U1.3 (D4)
KEY_P6: RN2.2 (R2.1), SW7.1, U1.4 (D5)
KEY_P7: RN2.3 (R3.1), SW8.1, U1.5 (D6)
KEY_P8: RN2.4 (R4.1), SW9.1, U1.6 (D7)
KEY_P9: RN3.1 (R1.1), SW10.1, U2.11 (D0)
KEY_P10: RN3.2 (R2.1), SW11.1, U2.12 (D1)
KEY_P11: RN3.3 (R3.1), SW12.1, U2.13 (D2)
KEY_P12: RN3.4 (R4.1), SW13.1, U2.14 (D3)
KEY_P13: RN4.1 (R1.1), SW14.1, U2.3 (D4)
KEY_P14: RN4.2 (R2.1), SW15.1, U2.4 (D5)
KEY_P15: RN4.3 (R3.1), SW16.1, U2.5 (D6)
KEY_P16: RN4.4 (R4.1), SW17.1, U2.6 (D7)
KEY_SHIFT: RN5.1 (R1.1), SW1.1, U3.11 (D0)
LED_CHG: D20.1 (K), R25.1
LED_D0: D1.2 (DIN), R1.2
LED_D1: D1.4 (DOUT), D2.2 (DIN)
LED_D2: D2.4 (DOUT), D3.2 (DIN)
LED_D3: D3.4 (DOUT), D4.2 (DIN)
LED_D4: D4.4 (DOUT), D5.2 (DIN)
LED_D5: D5.4 (DOUT), D6.2 (DIN)
LED_D6: D6.4 (DOUT), D7.2 (DIN)
LED_D7: D7.4 (DOUT), D8.2 (DIN)
LED_D8: D8.4 (DOUT), D9.2 (DIN)
LED_D9: D9.4 (DOUT), D10.2 (DIN)
LED_D10: D10.4 (DOUT), D11.2 (DIN)
LED_D11: D11.4 (DOUT), D12.2 (DIN)
LED_D12: D12.4 (DOUT), D13.2 (DIN)
LED_D13: D13.4 (DOUT), D14.2 (DIN)
LED_D14: D14.4 (DOUT), D15.2 (DIN)
LED_D15: D15.4 (DOUT), D16.2 (DIN)
LED_D16: D16.4 (DOUT), D17.2 (DIN)
LED_DATA: U4.2, U10.4 (GPIO2)
LED_DRV: R1.1, U4.4
MIDI_IN_A: D22.1 (K), R40.2, U19.1 (A)
MIDI_IN_R: J4.R, R40.1
MIDI_IN_S: C70.1, J4.S
MIDI_IN_T: D22.2 (A), J4.T, U19.3 (K)
MIDI_OUT_R: J5.R, R42.2, U20.1 (I/O1), U20.6 (I/O1)
MIDI_OUT_T: J5.T, R43.2, U20.3 (I/O2), U20.4 (I/O2)
MIDI_RX: R41.1, U10.32 (GPIO21), U19.5 (VO)
MIDI_TX: R43.1, U10.11 (GPIO8)
PGOOD_N: U10.5 (GPIO3), U13.7 (~PGOOD)
PWR_ON: R29.1, SW20.2 (B), U16.3 (ON)
Q1_G: Q1.1 (G), Q2.3 (C), R26.1
Q2_B: Q2.1 (B), R27.1
QSPI_SCLK: U10.52 (QSPI_SCLK), U11.6 (CLK)
QSPI_SD0: U10.53 (QSPI_SD0), U11.5 (DI(IO0))
QSPI_SD1: U10.55 (QSPI_SD1), U11.2 (DO(IO1))
QSPI_SD2: U10.54 (QSPI_SD2), U11.3 (IO2)
QSPI_SD3: U10.51 (QSPI_SD3), U11.7 (IO3)
QSPI_SS: R10.1, U10.56 (QSPI_SS), U11.1 (~CS)
RP_USB_DN: R16.2, U10.46 (USB_DM)
RP_USB_DP: R15.2, U10.47 (USB_DP)
RUN: R11.1, SW19.1, U10.26 (RUN)
SR_C13: U1.9 (Q7), U3.10 (DS)
SR_C21: U1.10 (DS), U2.9 (Q7)
SR_CLK: U1.2 (CP), U2.2 (CP), U3.2 (CP), U10.29 (GPIO18)
SR_DATA: U3.9 (Q7), U10.27 (GPIO16)
SR_LOAD: U1.1 (~PL), U2.1 (~PL), U3.1 (~PL), U10.28 (GPIO17)
SR_SPARE1: RN5.3 (R3.1), U3.13 (D2)
SR_SPARE2: RN5.4 (R4.1), U3.14 (D3)
SR_SPARE3: RN6.1 (R1.1), U3.3 (D4)
SR_SPARE4: RN6.2 (R2.1), U3.4 (D5)
SR_SPARE5: RN6.3 (R3.1), U3.5 (D6)
SR_SPARE6: RN6.4 (R4.1), U3.6 (D7)
SWCLK: TP1.1, U10.24 (SWCLK)
SWDIO: TP2.1, U10.25 (SWD)
SW_LED: D21.2 (A), L1.2, U18.1 (SW)
TS: R24.1, U13.1 (TS)
USB_DN: J3.A7 (D-), J3.B7 (D-), R16.1, U12.3 (I/O2), U12.4 (I/O2)
USB_DP: J3.A6 (D+), J3.B6 (D+), R15.1, U12.1 (I/O1), U12.6 (I/O1)
VBAT: C52.1, Q1.2 (S), Q2.2 (E), R44.1, U13.2 (BAT), U13.3 (BAT)
VBUS: C50.1, D20.2 (A), F1.2, U12.5 (VBUS), U13.13 (IN)
VBUS_IN: F1.1, J3.A4 (VBUS), J3.A9 (VBUS), J3.B4 (VBUS), J3.B9 (VBUS)
VDD_CORE: C37.1, C38.1, C39.1, U10.23 (DVDD), U10.45 (VREG_VOUT), U10.50 (DVDD)
VLED: C1.1, C2.1, C3.1, C4.1, C5.1, C6.1, C7.1, C8.1, C9.1, C10.1, C11.1, C12.1, C13.1, C14.1, C15.1, C16.1, C17.1, C18.1, C24.1, C61.1, C62.1, D1.3 (VDD), D2.3 (VDD), D3.3 (VDD), D4.3 (VDD), D5.3 (VDD), D6.3 (VDD), D7.3 (VDD), D8.3 (VDD), D9.3 (VDD), D10.3 (VDD), D11.3 (VDD), D12.3 (VDD), D13.3 (VDD), D14.3 (VDD), D15.3 (VDD), D16.3 (VDD), D17.3 (VDD), D21.1 (K), R30.1, U4.5 (VCC)
VSW: C56.1, C57.1, C60.1, L1.1, U16.6 (VOUT), U17.1 (VIN), U17.3 (EN), U18.4 (EN), U18.5 (IN)
VSYS: C51.1, C55.1, SW20.1 (A), U13.5 (EN2), U13.10 (OUT), U13.11 (OUT), U16.1 (VIN)
XIN: C41.1, U10.20 (XIN), Y1.1
XOUT: R12.1, U10.21 (XOUT)
XTAL_OUT: C42.1, R12.2, Y1.3

Notes on the sheet:
Power: USB-C, BQ24074, on/off, 5 V boosts, fuel gauge
ESP32-S3 dev board (YD-ESP32-S3) sockets
Switch inputs (3x 74HC165), encoder
Keys (Kailh hot-swap, MX)
Per-key RGB (SK6812MINI-E chain)
Connectors
Mechanical
midi
