samuelverburg-sys/PATS-MP16-DIY/hardware/mp16/mp16.kicad_pcb

## KiCad design hardware/mp16/mp16.kicad_pcb (continued)

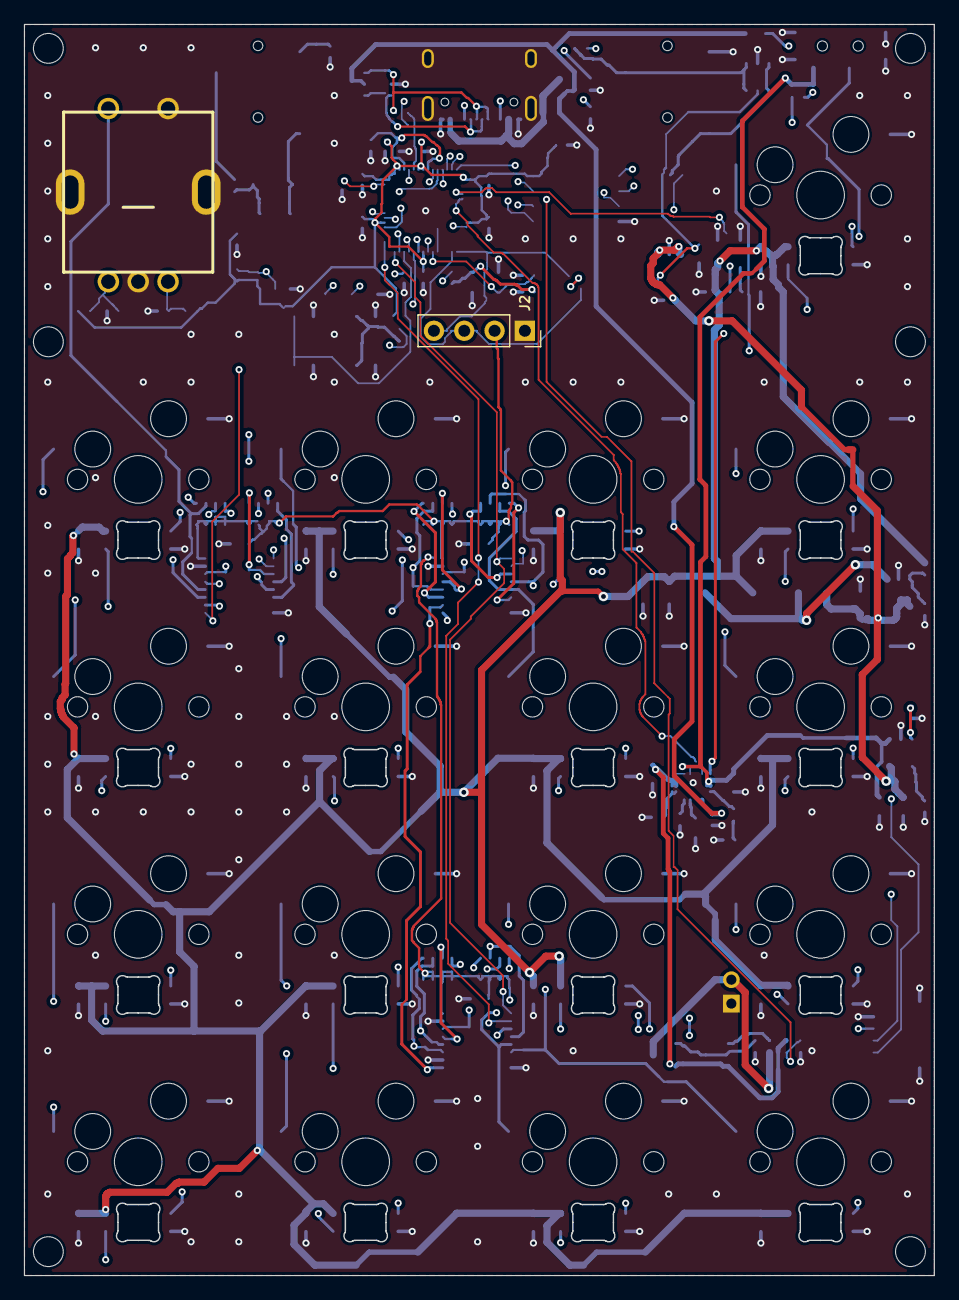
[picture p12: board mp16.kicad_pcb from above]

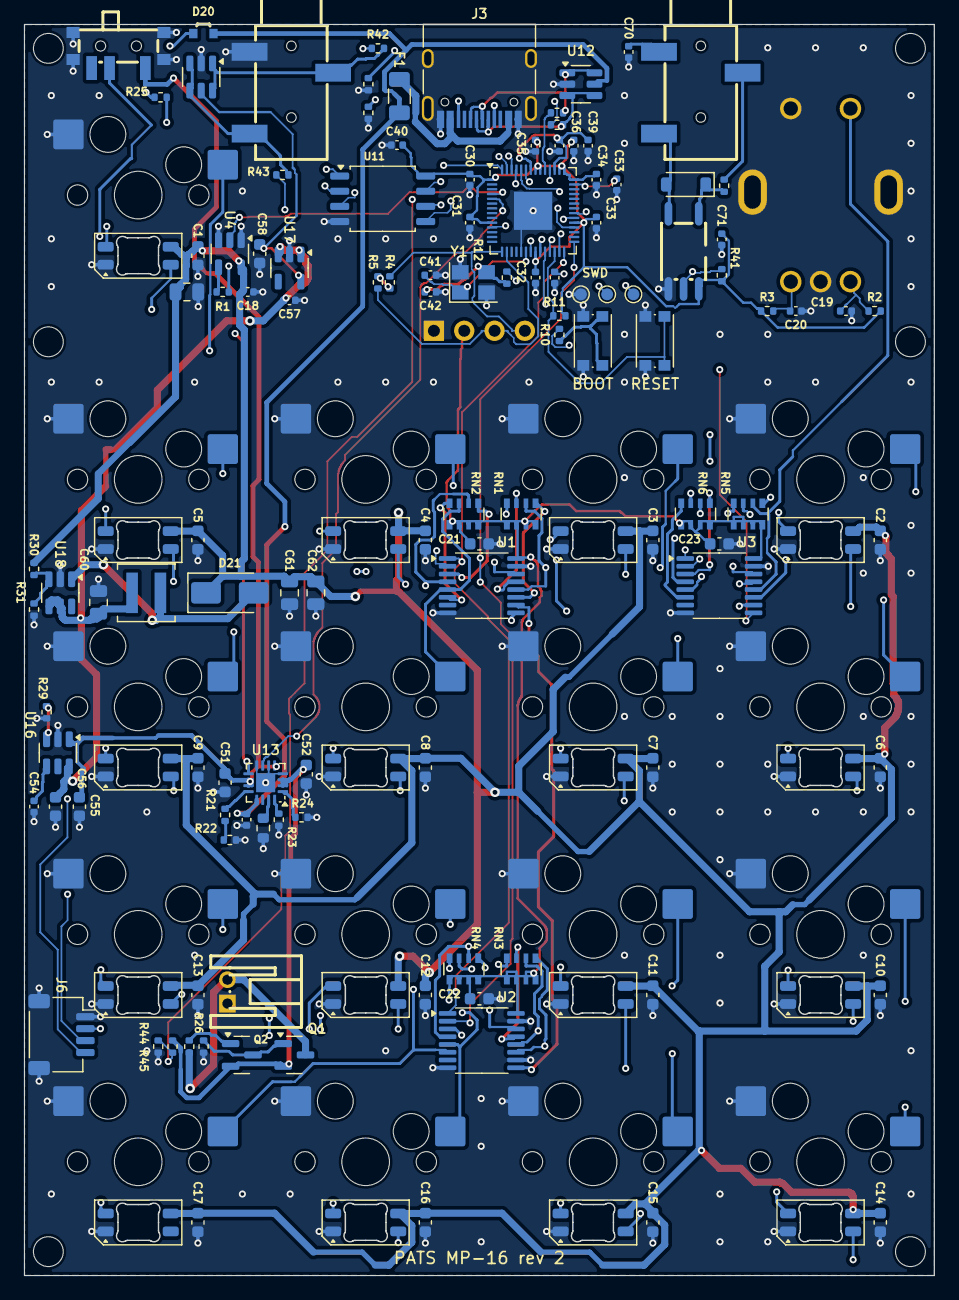
[picture p13: board mp16.kicad_pcb from below]

Board: 4 copper layers, 76.2 x 104.8 mm, 160 parts (152 on the bottom side), 104 nets.
