samuelverburg-sys/PATS-MP16-DIY/(commit log)

2026-10-22 Firmware on a shared MP16 library, both boards, Claude setup
    Start of PATS-MP16-DIY (rev 2 of the MP-16 DIY kit). Imported from
    samuelverburg/MP16-DIY-Kit: enclosure STLs, KLE layout, and the rev-1
    EasyEDA schematic and board (hardware/reference/). docs/SPEC.md records
    the decisions from the interview.
    Firmware:
    - firmware/libraries/MP16: one library the three sketches share.
    src/core/ is plain C++ (no Arduino.h): chord engine, music theory,
    MIDI parser, key and encoder input; host-tested (make -C firmware/test,
    ASan/UBSan, 1115 checks). MP16Board is the hardware layer; every pin is
    in board_pins.h. The board revision follows the Arduino board picked:
    Waveshare RP2040 Zero = rev 1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
2026-10-22 Rev 2 board: design.py, copied PATS generator, pins check (work in progress)
    hardware/mp16/design.py describes the whole rev 2 board: the PATS UI
    board's front-end (keys, LEDs, 3x 74HC165, encoder, OLED), a bare RP2040
    with W25Q128JV and 12 MHz crystal, USB-C with ESD and polyfuse, BQ24074
    charger with power path, battery reverse protection (P-MOSFET plus a PNP
    that keeps it off for a reversed pack even with USB present; decision
    0001), MAX17048 gauge, load switch, 3.3 V LDO, 5 V LED boost, TRS MIDI
    In (TLP109) and Out, a 2x6 expansion header. Jacks, USB-C, power switch,
    charge LED and battery plug sit on the rev-1 pad positions (pin_targets),
    checked against the enclosure STL openings. Netl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
2026-10-22 BOOT and RESET side by side with labels; fixed-part list; HIDE_REFS
    BOOT (SW18) and RESET (SW19) stand side by side in the lower left of the
    open bottom shell's window, each named on the bottom silkscreen, the SWD
    pads in a row above them (order in hardware/README.md). MIDI In parts
    moved to make room. tools/pcb.py: design.HIDE_REFS hides references a
    label already names. The side-view charge LED joins the parts that never
    move; the battery plug may move (Samuel). Not yet routed.
    Claude-Session: https://claude.ai/code/session_01P864NL83Ce2Z2DY4mgeMiF
2026-10-22 Routing: power and signals in one stage, ROUTE_PASSES cap
    Freerouting ignored the class split (the power stage got every net) and
    cycled between the same results until its 15-minute timeout, saving
    nothing. Escapes first, then everything else; design.ROUTE_PASSES = 10
    makes it hand over its best result to the finish router. The failed run
    is in build-log.jsonl.
    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
2026-10-22 hardware/README: JLCPCB constraints and how the board meets them
    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
2026-10-22 finish.py: report each net, time budget for rip-ups
    After both Freerouting stages routed every net, the finish router spent
    over 40 minutes silently in rip-up searches for a net it could not join.
    It now prints each net it joins or cannot join and gives a stuck net at
    most FINISH_RIPUP_SECONDS (default 90) of rip-up attempts.
    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
2026-10-22 Route 1 result and fixes: +3V3/VDD_CORE 0.2 mm, NPTH in fan-out
    First complete route: 39 unconnected pads in 10 nets, 5 DRC errors
    (build-log.jsonl). Causes and fixes:
    - +3V3 and VDD_CORE were 0.6 mm power nets, too wide for the RP2040's
    0.4 mm-pitch pads, the 74HC165s and 0402 parts (25 of the 39). Now a
    0.2 mm Supply class, routed with the RP2040's escapes.
    - The ground fan-out ignored bare (NPTH) holes: a via 0.16 mm from a key
    socket's centre hole. NPTH holes are obstacles now, 0.3 mm clearance.
    - The power switch's shield pads are 0.2 mm from the edge at the fixed
    rev-1 position (JLCPCB built rev 1 so): accepted, documented.
    - The accepted J5/SW1 courtyard overlap did not match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
2026-10-22 Move U3 into the key area (frees the RP2040's GPIO16-29 side)
    Route 2 left SR_CLK, SR_LOAD, EXP_MOSI, ENC_A and RUN unconnected: all
    leave the RP2040's left side (mirrored on the bottom), where U3 and its
    pull-up packs left a 1.5 mm channel. U3 moves between key rows 1 and 2,
    left of U1. Not routed yet.
    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
2026-10-22 Route 2 result; stitching vias keep hole clearance from bare holes
    Route 2 (0.2 mm Supply class): 11 unconnected (was 39) in 9 nets, 7 DRC
    errors. Six were stitching vias 0.10-0.23 mm from key-socket holes:
    finish.py kept only the drill, not the via's copper, off bare holes.
    Placed board with U3 in the key area (route 3 next).
    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
2026-10-22 Route 3 result; RP2040 re-placed with room around it
    Route 3 (U3 in the key area): 0 DRC errors, 10 unconnected in 9 nets,
    every one at an RP2040 pin (QSPI, VDD_CORE, SWDIO, I2C_SDA, MIDI_RX,
    PGOOD_N, EXP_MOSI, AIN1). Its capacitors touched the pin rows and walled
    pins in. Now: RP2040 3.8 mm left into the space U3 freed, capacitors
    1.9-2.2 mm out opposite their pins (positions computed from the pin
    geometry, rp_pin()), a top row for the supply caps and USB/BOOT
    resistors, flash against the QSPI corner, crystal under the right half,
    and locked escape stubs out of every RP2040 signal pin (ESCAPE).
    Claude-Session: https://claude.ai/code/s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
2026-11-03 Generator: true open-net count, quick mode, timings, 4-layer planes, PATS fixes
    Why the routing runs took 40-60 minutes and still failed:
    - Freerouting's log lists open nets only sometimes: every stage printed
    'all routed' while KiCad found 10-49 open connections, and rip-up
    rounds and the best-attempt choice went by that log. Open nets now
    come from KiCad's DRC (0.7 s on this board).
    - The finish router walked every net and rebuilt the board geometry for
    each (25-40 min); it now gets only the nets KiCad reports open.
    - 'build.py <board> quick': Freerouting only, 3 passes, every open
    connection listed with positions; a timing line on every run.
    4 layers (design.LAYERS, design.PLAN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
2026-11-03 Power section into the key area; USB entry untangled; one routing stage
    On 4 layers the router still left ~34 connections open after 5 passes,
    clustered where the power section and the RP2040 shared the top band.
    Charger between keys 7 and 8, load switch beside key 8, battery plug
    (movable, Samuel) and its protection between keys 11 and 12, gauge
    beside key 12. USB ESD moved left of USB-C (towards the RP2040's USB
    pins), fuse and CC resistors to its right. One routing stage: the class
    split was not honoured anyway. Quick route running.
    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
2026-11-03 Free the QSPI pins' way out; finish router time cap
    USB series resistors move beside the ESD chip and the BOOT resistor next
    to its button: above the RP2040's QSPI pins they walled the flash lines
    in (quick route: 17 open in 12 nets). finish.py: FINISH_TOTAL_SECONDS
    (default 600) caps the whole finish.
    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
2026-11-03 Flash turned (rows left/right), USB lane in the top row; windowed finish search
    Full build (power in the key area): Freerouting left 10 open in 9 nets;
    the finish router joined 3 in its 10-minute cap. Its A* searched the
    whole board (80-90 s per stuck net, even for 1.5 mm hops): it now tries a
    4 mm, then 12 mm window around the two pieces before the whole board.
    Placement: flash pin rows left and right at (46.2, 14.6), its far row
    had only a 1.2 mm channel; C35 and C39 leave a lane for the USB pair.
    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
2026-11-03 Skip ground joining on boards with a ground plane
    join_ground sees only the outer pours, so on a 4-layer board it 'joined'
    areas the inner ground plane already joins, up to 90 s each. With a
    ground plane it is skipped; DRC still checks ground connectivity.
    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
2026-11-03 Generator: short hops routed first and locked; parallel Freerouting attempts
    prejoin_short (design.PREROUTE_MM = 3): pieces of a net within 3 mm are
    joined by the grid router before Freerouting and locked; Freerouting
    kept failing such hops in crowded corners. ROUTE_PARALLEL = 3: three
    Freerouting runs at once with different margins, the best by KiCad's
    count kept (results swung 10-19 open between near-identical runs).
    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
2026-11-03 4-layer board routed: DRC 0 errors, 1 unconnected (RP_USB_DN)
    Full build on the current placement (power in the key area, flash
    turned, USB lane): Freerouting left 19 open in 11 nets, the finish
    router joined 10 of them (windowed search, 425 s), RP_USB_DN stays open.
    DRC: 0 errors besides that one. 19.3 min in all. Not yet on the new
    generator steps (pre-routed short hops, parallel attempts).
    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
2026-11-03 Layer count switchable: 2 layers by default (Samuel), MP16_LAYERS=4 for the plane variant
    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
2026-11-03 GPIO map follows the board: each signal on the side it leaves towards
    The RP2040 sits on the bottom (mirrored): GPIO0-11 face right, 12-17
    down, 18-29 left. 2-layer experiment A (prejoin + 3 parallel Freerouting
    runs): 13 open after Freerouting, among them MIDI_RX, ENC_A/B (to the
    left, on right-side pins) and PGOOD_N. New map: MIDI on UART1 (TX GP8
    right, RX GP21 left), I2C0 on GP12/13 (towards the OLED), encoder GP22/23
    (left), PGOOD_N GP3 (right). Rev 1 keeps its pins; the board layer picks
    the UART per revision. check-pins: 0 mismatches; all six firmware builds
    pass. Full 2-layer build running.
    Claude-Session: https://claude.ai/cod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
2026-11-03 Regenerated schematic and placed board for the new GPIO map
    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
2026-11-03 RP2040 1 mm left (USB lane clears the USB-C shell leg); ISET/ITERM swapped
    2-layer build (new GPIO map, prejoin, 3 parallel runs): 8 open in 7
    nets after Freerouting (best of 12/8/12), the finish router joined 4;
    open: ISET, RP_USB_DN, RP_USB_DP. The USB lane in the top capacitor row
    sat under USB-C's shell leg; the RP2040 moves 1 mm left with its top row,
    RUN pull-up and SWD pads. R20 (ISET) and R23 (ITERM) swapped (they were
    in crossing order). Not routed yet.
    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
2026-11-03 2-layer build result: DRC run on the routed board (build log)
    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
2026-11-03 Generator: safer router margins and edge insets; RP2040 1 mm left, ISET/ITERM swapped, C40 turned
    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
2026-11-03 BOOT and RESET labels under their switches (R10 took the old BOOT spot)
    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
2026-11-03 Trial: RP2040 capacitors, flash and crystal on the top side (MP16_MCU_SIDE, default F)
    Bottom-only 2-layer route left 8 nets open around the RP2040 (USB pair, QSPI_SD3, RUN, VDD_CORE).
    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
2026-11-03 Trial board regenerated (MCU parts on top, unrouted)
    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
2026-11-03 Trial board regenerated before full route
    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
2026-11-03 Pre-route by priority, then by distance (deterministic); R12 back on the bottom
    Priority nets (USB, crystal, QSPI, VDD_CORE, ISET/ITERM) are routed and locked first up to 15 mm,
    then every other net shortest hop first, instead of alphabetically.
    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
2026-11-03 Ground fan-out on both sides (top RP2040 capacitors); trial route: 0 DRC errors, 3 open
    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
2026-11-03 Priority pre-route: USB, crystal and charger only (QSPI/VDD_CORE first walled in GPIO pins)
    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
2026-11-03 Edge inset in the right units, PGOOD_N pre-routed with its own reach, ground joining budget
    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
2026-11-03 Routing journal: run 8 (edge inset, 0 DRC errors); charger group is the recurring trouble spot
    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
2026-11-03 Run 9: charger group moved to the free band under the OLED
    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
2026-11-03 Expansion header: AIN4..AIN1 left to right (uncrossed tracks to the RP2040's ADC pins)
    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
2026-11-03 Run 9 in progress: board and log
    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
2026-11-03 Run 10: R21/R22 beside the ILIM pin; journal run 9
    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
2026-11-03 Run 12: uncross ENC, SWD and expansion header ends; crossing and through-hole checks
    ENC_A/B on GPIO23/22 (board_pins.h, SPEC), SWD pads SWDIO, SWCLK, GND, header pins 7-9 reordered,
    J6 back in place. Placement check: through-hole parts against the other side; facing check: crossed
    connections from neighbouring chip pins to connectors, test pads and encoders. Congestion on 0.25 mm cells.
    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
2026-11-03 Run 12 in progress: board and log
    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
2026-11-03 Run 13 prepared: encoder pull-ups and filter caps on the top side
    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
2026-11-03 Run 12 routed: board and log
    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
2026-11-03 4 layers, one assembly side; Qwiic connector; battery divider instead of the fuel gauge
    Samuel's decisions after the data review (docs/decisions/0002): 4 layers with every SMD part on the
    bottom; the 2x6 expansion header becomes a 4-pin JST SH I2C connector (Qwiic pinout) at the bottom
    edge; the MAX17048 becomes a 1M/1M divider into GPIO29 (core/battery.h, host-tested). The 5 V LED
    boost stays (SK6812MINI-E: 3.7-5.5 V). Placement check: mounting holes count as through-hole parts;
    the far-side check skips plane nets. Docs, SPEC GPIO table, checklist and parts table updated.
    Claude-Session: https://claude.ai/code/session_01P864NL83Ce2Z2D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
2026-11-03 1M divider resistors: LCSC C26083 (unverified); parts table
    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
2026-11-03 Run 15 in progress: schematic and board
    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
2026-11-03 Run 15: 5 nets open after Freerouting on 4 layers; finish crashed on an inner-layer track
    The grid finish router (tools/finish.py) knows only F.Cu and B.Cu; In2 tracks raise KeyError in
    build_blocks. Next step recorded in the routing journal. Stopped here at Samuel's request.
    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
2026-11-04 Finish router knows inner layers; fan-out off plated holes; promote round after parallel attempts; Qwiic on the right edge; charger A/B switch
    Diagnosis 2026-11-04 (ROUTING-LOG.md): run 15 crashed in finish.py on an In2 track; the fan-out drilled
    two vias into USB-C's shell legs. New: ROUTE_PROMOTE_PARALLEL (nets left open routed first, then the
    parallel attempts again), COURTYARD_OK, MP16_CHARGER=band|keys for the A/B qualifying runs.
    Samuel: In2 a signal layer, charger by A/B test, Qwiic on a side edge.
    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
2026-11-04 Grow the LED cut-out keep-outs by the edge clearance; accept the J6 courtyard overlaps in DRC
    Run 16B: 23 inner-layer tracks 0.16-0.30 mm from LED window edges (rule 0.3). Keep-outs on all
    signal layers now grow by 0.32 mm (as the outline inset).
    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
2026-11-04 Run 17 (final): charger between key rows 2 and 3 (A/B winner), promote round on, finish clearance +0.03
    A/B (ROUTING-LOG.md): 16B keys 1 net open after finish, 16A band 3. 16B's records copied into the log.
    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
2026-11-04 Order check: each pin's nearest part, so nets with several capacitors are checked; pipeline notes
    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
2026-11-04 Run 19: 0 DRC errors, 3 open (QSPI_SCLK, QSPI_SD0, SWDIO); run 20 prepared: pre-route kept out of QFN pin rings
    The pre-route joined neighbouring same-net RP2040 pins through the pin ring (37 tracks, 6 vias before
    routing), walling the other pins' escapes in. PREROUTE_KEEP_INSIDE blocks tracks and vias inside the
    listed parts' pin rings. Not run yet: waiting for Samuel's OK.
    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
2026-11-05 Run 20 started: board and schematic regenerated
    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
2026-11-05 Routing mode switch MP16_ROUTE_MODE=balanced|freerouting|grid (record runs)
    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
2026-11-05 Run 20: 0 DRC errors, 1 open (RP_USB_DN); run 22 prepared: R15/R16 turned, top capacitor row 0.2 mm left; record runs 21G/21F started
    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
2026-11-05 Record runs 21F (Freerouting-heavy) and 21G (grid-heavy) against run 20 (balanced)
    Balanced: 1 open, 0 errors, 35 min. Freerouting-heavy: 2 open + 14 ground islands, 4 errors, 27 min.
    Grid-heavy: 6 open, 0 errors, 39 min. Records copied into the build log; journal updated.
    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
2026-11-05 Run 22: USB lane cleared (R15/R16 turned, top capacitors 0.2 mm left), R29 beside U16's PWR_ON pin
    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
2026-11-05 Run 22: fully routed, DRC 0 errors and 0 unconnected; fab files
    4 layers (In1 GND plane, In2 signals), every SMD part on the bottom. Gerbers, BOM (51 lines) and
    CPL (148 parts) in hardware/mp16/fab/. Review: 7 decoupling caps further than 3 mm, 5 power nets
    with long thin runs (to check before ordering).
    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
2026-11-05 Run 23 (polish): power nets on the outer layers in Freerouting, 0.3 mm power fallback, C60 beside the boost input
    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
2026-11-05 Run 23: fully routed, DRC 0/0, power nets at least 0.3 mm and off the inner layer; fab files
    Narrowest power tracks against run 22: VBUS/VSYS/VBAT 0.15 -> 0.30 mm, VLED 0.36 -> 0.45, SW_LED
    0.45 -> 0.60; no power net on In2.Cu; C60 3.3 mm from the boost input (was 7.7).
    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
